shravanmali/Aura-v1/cad/scad_exploded_render.png

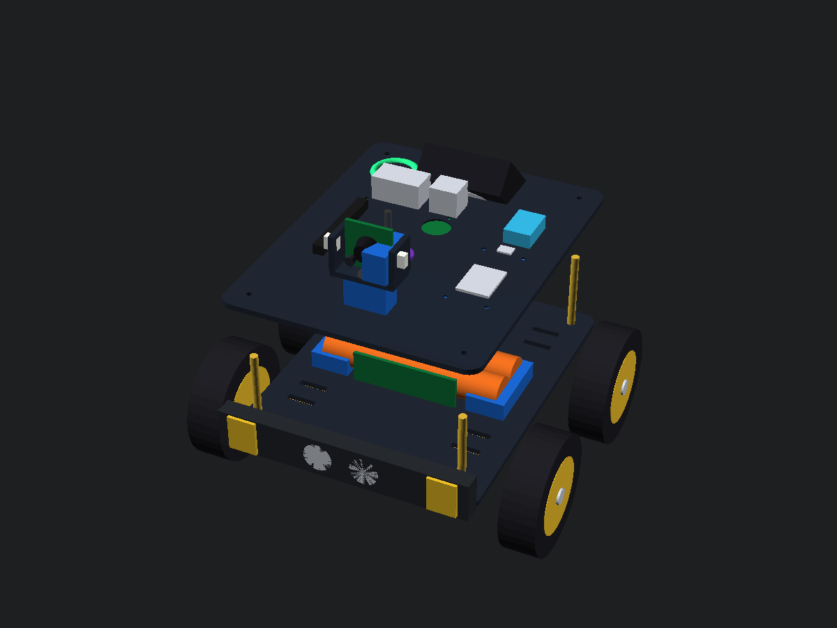
cad/scad_exploded_render.png
