shravanmali/Aura-v1/hardware/Aura_Rover_Carrier_Final/3d_pcb_carrier_top.png

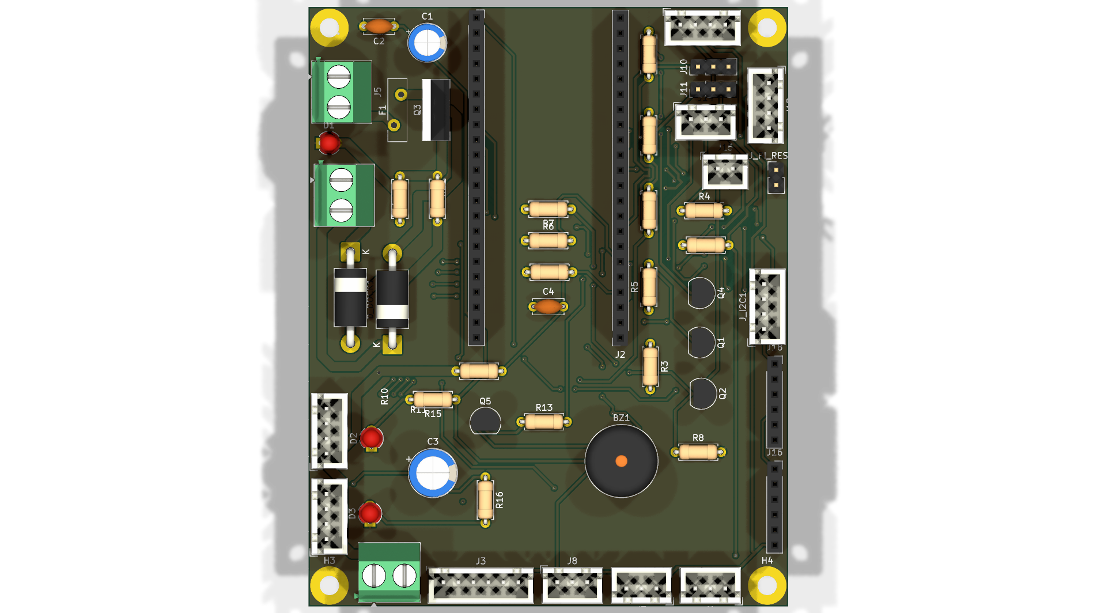
hardware/Aura_Rover_Carrier_Final/3d_pcb_carrier_top.png
