shravanmali/Aura-v1/hardware/Aura_Satellite_Pod/3d_pcb_back.png

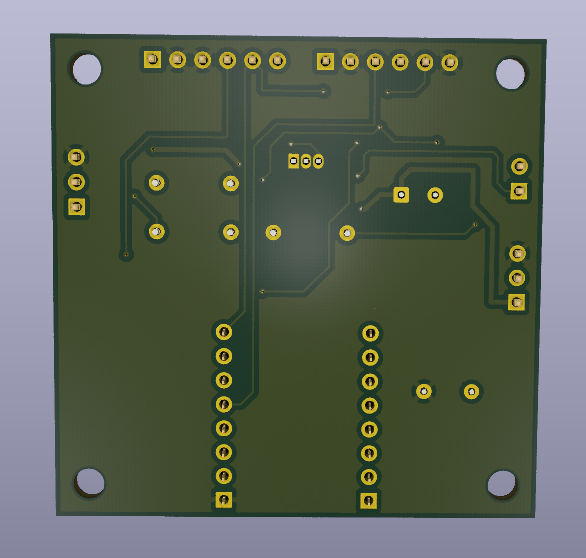
hardware/Aura_Satellite_Pod/3d_pcb_back.png
