shravanmali/Aura-v1/hardware/Aura_Satellite_Pod/3d_pcb_front.png

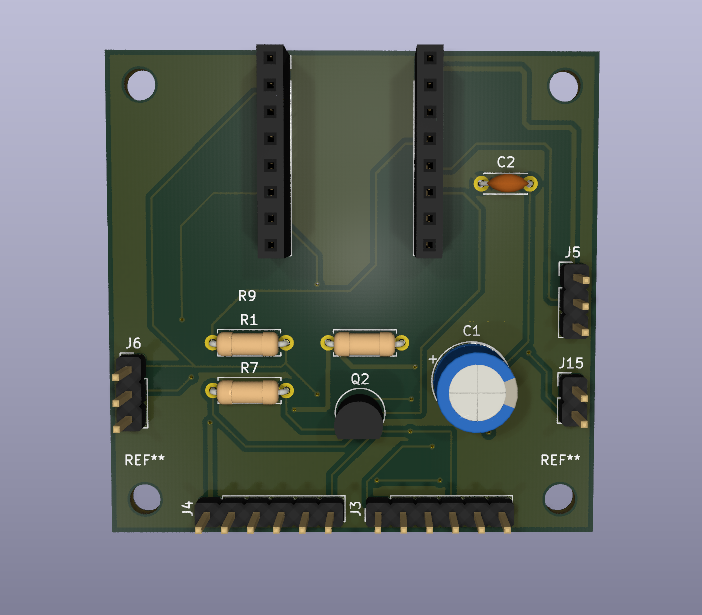
hardware/Aura_Satellite_Pod/3d_pcb_front.png
