shravanmali/Aura-v1/Aura_Master_BOM.md

# Aura v1 — Complete Master System BOM (0 to 100)

> This document lists every single hardware component in the Aura Autonomous Mobile Companion Robot & Bedroom Satellite Mesh.  
> It separates hardware already owned on my desk from hardware requested through the Hack Club Fallen Grant.

---

### Section 1: Hardware Owned by Me (Already on My Desk — ₹0 Grant Needed)

| Item No. | Component Name | Subsystem / Role | Status | Qty | Estimated Value (INR) | Source / Notes |
| :---: | :--- | :--- | :---: | :---: | :---: | :--- |
| D1 | ESP32-S3 DevKit-C (N16R8) | Rover Real-Time Controller & Kinematics | `OWNED / ON DESK` | 1 | ₹850 | On desk (Dual-core 240MHz, 16MB Flash, 8MB PSRAM) |
| D2 | 200RPM Geared BO Motors (3-6V DC) | 4WD Skid-Steer Locomotion | `OWNED / ON DESK` | 4 | ₹240 | On desk (dual parallel pairs for high torque) |
| D3 | High-Grip 65mm Rubber BO Wheels | Rover Ground Traction | `OWNED / ON DESK` | 4 | ₹200 | On desk (rubber tread wheels) |
| D4 | L298N Dual H-Bridge Motor Driver | 4WD Motor Power Driver (up to 2A/channel) | `OWNED / ON DESK` | 1 | ₹160 | On desk (heatsink module driven via ESP32 PWM) |
| D5 | 2-Axis Pan-Tilt Gimbal Bracket Kit | Camera Pan-Tilt Mount (SG90/MG90S footprint) | `OWNED / ON DESK` | 1 | ₹120 | On desk (mechanics for camera tracking) |
| D6 | Laser-Cut Acrylic Dual-Deck Chassis | Rover Structural Body & Standoffs | `OWNED / ON DESK` | 1 | ₹350 | On desk (base deck for motors, top deck for electronics) |
| D7 | DHT11 Temperature & Humidity Sensor | Ambient Room Climate Telemetry | `OWNED / ON DESK` | 1 | ₹70 | On desk (bench tested in Journal #4) |
| D8 | HC-SR501 PIR Motion Sensor | Low-Power Night Sentry Intrusion Alarm | `OWNED / ON DESK` | 1 | ₹65 | On desk (bench tested in Journal #4) |
| D9 | 2N2222 NPN Bipolar Transistors (TO-92) | High-pulse IR LED Driver & Switching | `OWNED / ON DESK` | 3 | ₹15 | Desk parts stock (used in satellite pod circuit) |
| D10 | 940nm High-Power Infrared (IR) LEDs | TV & Air Conditioner Voice Remote Blaster | `OWNED / ON DESK` | 2 | ₹20 | Desk parts stock (narrow-beam 5mm IR emitter) |
| D11 | 1/4W Metal Film Precision Resistors | Fuel Gauge (100k/33k), Pullups, Base Drive | `OWNED / ON DESK` | 15+ | ₹30 | Desk parts stock (100k, 33k, 4.7k, 1k, 100, 47 ohm) |
| D12 | 470µF 25V Low-ESR Electrolytic Capacitor | Audio Inrush Buffer (Prevents speaker brownout) | `OWNED / ON DESK` | 1 | ₹10 | Desk stock (placed across MAX98357A 5V rail) |
| D13 | Single-Sided Copper Perfboard / Zero PCB | Initial Soldered Hardware Carrier Shield | `OWNED / ON DESK` | 1 | ₹40 | On desk (bench wiring shield) |
| D14 | Smartphone (DroidCam USB/Wi-Fi Stream) | Interim CV Camera Node (1080p @ 30 FPS) | `OWNED / ON DESK` | 1 | ₹0 | Personal phone used while awaiting Pi CSI camera |
| D15 | 5V 2A USB Mobile Charger + USB-C Cable | Bedroom Satellite Pod 24/7 Wall Power | `OWNED / ON DESK` | 1 | ₹150 | Spare phone charger used to power the pod |
| — | **Subtotal: Owned Hardware** | **15 Subsystems Already on My Desk** | — | — | **₹2,320** | **Owned by me (I have on my desk)** |

---

### Section 2: Hack Club Fallen Grant Request (₹9,528 / ~$100.67)

| Item No. | Component Name | Purpose on Aura v1 | Status | Qty | Unit Price (INR) | Total Price (INR) | Vendor | Purchase Link |
| :---: | :--- | :--- | :---: | :---: | :---: | :---: | :---: | :---: |
| G1 | Raspberry Pi 4 Model B (1GB) | Main AI Brain & Computer Vision | `REQUESTED` | 1 | ₹4,499 | ₹4,499 | Robocraze | [robocraze.com](https://robocraze.com/products/raspberry-pi-4-model-b-1gb-ram) |
| G2 | 160° Wide-Angle CSI Camera (OV5647) | Person Tracking & Auto-Docking | `REQUESTED` | 1 | ₹939 | ₹939 | Robu.in | [robu.in](https://robu.in/product/5mp-ov5647-sensor-adjustable-wide-angle-fish-eye-lens-night-vision-camera-for-raspberry-pi-3-b/) |
| G3 | TowerPro MG90S Metal Gear Servos | 2-Axis Pan-Tilt Camera Gimbal | `REQUESTED` | 2 | ₹269 | ₹538 | Robu.in | [robu.in](https://robu.in/product/mg90s-9g-servo-metal-gear/) |
| G4 | XL4015 5A DC-DC Buck Converter | 5.1V Clean Power Rail for Pi 4B | `REQUESTED` | 1 | ₹110 | ₹110 | Robocraze | [robocraze.com](https://robocraze.com/products/xl4015-dc-dc-step-down-adjustable-power-supply-module) |
| G5 | LM2596S 3A DC-DC Buck Converter | 5.0V Rail for Servos & LEDs | `REQUESTED` | 1 | ₹62 | ₹62 | Robocraze | [robocraze.com](https://robocraze.com/products/lm2596-dc-dc-buck-module) |
| G6 | 18650 2600mAh Li-ion Cells (3S2P) | 11.1V 5200mAh High-Torque Pack | `REQUESTED` | 6 | ₹149 | ₹894 | MakerBazar | [makerbazar.in](https://makerbazar.in/products/youxi-18650-3-7v-lithium-ion-rechargeable-battery) |
| G7 | 3S 20A Li-ion BMS Protection Board | Battery Safety & Balance Protection | `REQUESTED` | 1 | ₹49 | ₹49 | MakerBazar | [makerbazar.in](https://makerbazar.in/products/12-6v-bms-3s-20a-18650-lithium-battery-management-board) |
| G8 | 12V 2A DC Power Adapter | Auto-Docking Station Power Supply | `REQUESTED` | 1 | ₹129 | ₹129 | MakerBazar | [makerbazar.in](https://makerbazar.in/products/hi-light-led-power-dc-supply-adapter?variant=50055364641008) |
| G9 | ESP32-C3 SuperMini Board | Stationary Bedroom Satellite Pod | `REQUESTED` | 1 | ₹254 | ₹254 | Robocraze | [robocraze.com](https://robocraze.com/products/esp32-c3-super-mini-development-board-unsoldered) |
| G10 | INMP441 I2S MEMS Microphone | Digital Voice AI Input for Pi | `REQUESTED` | 1 | ₹115 | ₹115 | Robocraze | [robocraze.com](https://robocraze.com/products/inmp441-mems-high-precision-omnidirectional-microphone-module-i2s) |
| G11 | SmartElex MAX98357A I2S Amplifier | 3.2W Class-D Digital Audio Amp | `REQUESTED` | 1 | ₹195 | ₹195 | Robocraze | [robocraze.com](https://robocraze.com/products/smartelex-max98357a-i2s-audio-breakout-amplifier-for-raspberry-pi-and-microcontrollers) |
| G12 | 3-inch 4Ω 10W Speaker | Room Voice & Music Playback | `REQUESTED` | 1 | ₹84 | ₹84 | MakerBazar | [makerbazar.in](https://makerbazar.in/products/senior-sound-subwoofer-multimedia-speaker?variant=48251030667504) |
| G13 | WS2812 16-Bit RGB LED Ring | Visual State Feedback Lightbar | `REQUESTED` | 1 | ₹78 | ₹78 | Robocraze | [robocraze.com](https://robocraze.com/products/ws2812-16-bit-rgb-led-round) |
| G14 | SanDisk Ultra 64GB MicroSD Card | Raspberry Pi OS & Model Storage | `REQUESTED` | 1 | ₹1,299 | ₹1,299 | Amazon.in | [amazon.in](https://www.amazon.in/SANDISK-microSD-Android-Smartphones-Warranty/dp/B0GWW13HC3/) |
| G15 | HC-SR04 Ultrasonic Distance Sensor | Front Obstacle Collision Shield | `REQUESTED` | 1 | ₹75 | ₹75 | Robocraze | [robocraze.com](https://robocraze.com/products/hc-sr-04-ultrasonic-sensor) |
| G16 | 40-Pin Dupont Jumper Wires Kit | Interconnect Wiring & Prototyping | `REQUESTED` | 1 | ₹110 | ₹110 | MakerBazar | [makerbazar.in](https://makerbazar.in/products/jumper-cable-male-female) |
| G17 | 3x 18650 Battery Holder with Leads | 3S2P Battery Pack Assembly | `REQUESTED` | 2 | ₹49 | ₹98 | Robu.in | [robu.in](https://robu.in/product/plastic-box-battery-cell-holder-for-4-x-aa-battery-with-on-off-switch/) |
| **TOTAL** | **Complete System Grant Request** | **Aura Rover + Bedroom Satellite Mesh** | — | **17 Items** | — | **₹9,528** | **All Vendors Combined** | **~$100.67 USD** |

---

### Master Total System Value (Owned + Grant)
* **Total Hardware Investment (32 Subsystems):** **₹11,848 (~$125.10 USD)**
  * **Owned by me (I have on my desk):** ₹2,320 (19.6%)
  * **Requested from Hack Club Fallen:** ₹9,528 (80.4%)
