shravanmali/Aura-v1/BOM.md

# Aura v1 — Hardware Grant Request Bill of Materials (BOM)

> **Submission for Hack Club Fallen Grant Review**  
> Total Items: **17 Components** | Total Funding Requested: **₹9,528 (~$100.67 USD)**

| Item No. | Component Name | Purpose on Aura v1 | Quantity | Unit Price (INR) | Total Price (INR) | Total Price (USD) | Vendor | Purchase Link |
| :---: | :--- | :--- | :---: | :---: | :---: | :---: | :---: | :---: |
| 1 | Raspberry Pi 4 Model B (1GB) | Main AI Brain & Computer Vision | 1 | ₹4,499 | ₹4,499 | $47.53 | Robocraze | [robocraze.com](https://robocraze.com/products/raspberry-pi-4-model-b-1gb-ram) |
| 2 | 160° Wide-Angle CSI Camera (OV5647) | Person Tracking & Auto-Docking | 1 | ₹939 | ₹939 | $9.92 | Robu.in | [robu.in](https://robu.in/product/5mp-ov5647-sensor-adjustable-wide-angle-fish-eye-lens-night-vision-camera-for-raspberry-pi-3-b/) |
| 3 | TowerPro MG90S Metal Gear Servos | 2-Axis Pan-Tilt Camera Gimbal | 2 | ₹269 | ₹538 | $5.68 | Robu.in | [robu.in](https://robu.in/product/mg90s-9g-servo-metal-gear/) |
| 4 | XL4015 5A DC-DC Buck Converter | 5.1V Clean Power Rail for Pi 4B | 1 | ₹110 | ₹110 | $1.16 | Robocraze | [robocraze.com](https://robocraze.com/products/xl4015-dc-dc-step-down-adjustable-power-supply-module) |
| 5 | LM2596S 3A DC-DC Buck Converter | 5.0V Rail for Servos & LEDs | 1 | ₹62 | ₹62 | $0.66 | Robocraze | [robocraze.com](https://robocraze.com/products/lm2596-dc-dc-buck-module) |
| 6 | 18650 2600mAh Li-ion Cells (3S2P) | 11.1V 5200mAh High-Torque Pack | 6 | ₹149 | ₹894 | $9.45 | MakerBazar | [makerbazar.in](https://makerbazar.in/products/youxi-18650-3-7v-lithium-ion-rechargeable-battery) |
| 7 | 3S 20A Li-ion BMS Protection Board | Battery Safety & Balance Protection | 1 | ₹49 | ₹49 | $0.52 | MakerBazar | [makerbazar.in](https://makerbazar.in/products/12-6v-bms-3s-20a-18650-lithium-battery-management-board) |
| 8 | 12V 2A DC Power Adapter | Auto-Docking Station Power Supply | 1 | ₹129 | ₹129 | $1.36 | MakerBazar | [makerbazar.in](https://makerbazar.in/products/hi-light-led-power-dc-supply-adapter?variant=50055364641008) |
| 9 | ESP32-C3 SuperMini Board | Stationary Bedroom Satellite Pod | 1 | ₹254 | ₹254 | $2.68 | Robocraze | [robocraze.com](https://robocraze.com/products/esp32-c3-super-mini-development-board-unsoldered) |
| 10 | INMP441 I2S MEMS Microphone | Digital Voice AI Input for Pi | 1 | ₹115 | ₹115 | $1.22 | Robocraze | [robocraze.com](https://robocraze.com/products/inmp441-mems-high-precision-omnidirectional-microphone-module-i2s) |
| 11 | SmartElex MAX98357A I2S Amplifier | 3.2W Class-D Digital Audio Amp | 1 | ₹195 | ₹195 | $2.06 | Robocraze | [robocraze.com](https://robocraze.com/products/smartelex-max98357a-i2s-audio-breakout-amplifier-for-raspberry-pi-and-microcontrollers) |
| 12 | 3-inch 4Ω 10W Speaker | Room Voice & Music Playback | 1 | ₹84 | ₹84 | $0.89 | MakerBazar | [makerbazar.in](https://makerbazar.in/products/senior-sound-subwoofer-multimedia-speaker?variant=48251030667504) |
| 13 | WS2812 16-Bit RGB LED Ring | Visual State Feedback Lightbar | 1 | ₹78 | ₹78 | $0.82 | Robocraze | [robocraze.com](https://robocraze.com/products/ws2812-16-bit-rgb-led-round) |
| 14 | SanDisk Ultra 64GB MicroSD Card | Raspberry Pi OS & Model Storage | 1 | ₹1,299 | ₹1,299 | $13.72 | Amazon.in | [amazon.in](https://www.amazon.in/SANDISK-microSD-Android-Smartphones-Warranty/dp/B0GWW13HC3/) |
| 15 | HC-SR04 Ultrasonic Distance Sensor | Front Obstacle Collision Shield | 1 | ₹75 | ₹75 | $0.79 | Robocraze | [robocraze.com](https://robocraze.com/products/hc-sr-04-ultrasonic-sensor) |
| 16 | 40-Pin Dupont Jumper Wires Kit | Interconnect Wiring & Prototyping | 1 | ₹110 | ₹110 | $1.16 | MakerBazar | [makerbazar.in](https://makerbazar.in/products/jumper-cable-male-female) |
| 17 | 3x 18650 Battery Holder with Leads | 3S2P Battery Pack Assembly | 2 | ₹49 | ₹98 | $1.04 | Robu.in | [robu.in](https://robu.in/product/plastic-box-battery-cell-holder-for-4-x-aa-battery-with-on-off-switch/) |
| **TOTAL** | **Complete System BOM (Rover + Pod)** | **Full Hardware Grant Request** | **17 Items** | — | **₹9,528** | **$100.67** | **All Vendors Combined** | — |
