shravanmali/Aura-v1/hardware/Aura_Rover_Carrier_Final/Aura_Rover_Carrier_Final_BOM.csv

Item | Reference | Value | Footprint
1 | BZ1 | 5V_ACTIVE_BUZZER | Buzzer_Beeper:Buzzer_12x9.5RM7.6
2 | C1 | 100uF 16V | Capacitor_THT:CP_Radial_D6.3mm_P2.50mm
3 | C2 | 100nF | Capacitor_THT:C_Disc_D5.0mm_W2.5mm_P5.00mm
4 | C3 | 470uF 25V Low-ESR | Capacitor_THT:CP_Radial_D8.0mm_P3.50mm
5 | C4 | 100nF | Capacitor_THT:C_Disc_D5.0mm_W2.5mm_P5.00mm
6 | D1 | Green (11.1V OK) | LED_THT:LED_D3.0mm
7 | D2 | Blue (Logic 5V OK) | LED_THT:LED_D3.0mm
8 | D3 | Amber (Servo 5V OK) | LED_THT:LED_D3.0mm
9 | D_DOCK1 | SS54 | Diode_THT:D_DO-201AD_P15.24mm_Horizontal
9b | D_CHG1 | SS54 | Diode_THT:D_DO-201AD_P15.24mm_Horizontal
10 | F1 | 5A 16V Polyfuse | Fuse:Fuse_Bourns_MF-RHT500
11 | H1 | M3_Mounting_Hole | MountingHole:MountingHole_3.2mm_M3_Pad
12 | H2 | M3_Mounting_Hole | MountingHole:MountingHole_3.2mm_M3_Pad
13 | H3 | M3_Mounting_Hole | MountingHole:MountingHole_3.2mm_M3_Pad
14 | H4 | M3_Mounting_Hole | MountingHole:MountingHole_3.2mm_M3_Pad
15 | J1 | ESP32_LEFT | Connector_PinSocket_2.54mm:PinSocket_1x22_P2.54mm_Vertical
16 | J2 | ESP32_RIGHT | Connector_PinSocket_2.54mm:PinSocket_1x22_P2.54mm_Vertical
17 | J3 | L298N_MOTOR_PORT | Connector_JST:JST_XH_B6B-XH-A_1x06_P2.50mm_Vertical
18 | J4 | 5V_BUCK_REGULATOR | Connector_JST:JST_XH_B4B-XH-A_1x04_P2.50mm_Vertical
19 | J5 | 11.1V_BATT_IN | TerminalBlock_Phoenix:TerminalBlock_Phoenix_MKDS-1,5-2-5.08_1x02_P5.08mm_Horizontal
20 | J6 | HC-SR04_ULTRASONIC | Connector_JST:JST_XH_B4B-XH-A_1x04_P2.50mm_Vertical
21 | J7 | DHT11_Sensor | Connector_JST:JST_XH_B3B-XH-A_1x03_P2.50mm_Vertical
22 | J8 | PIR_Motion | Connector_JST:JST_XH_B3B-XH-A_1x03_P2.50mm_Vertical
23 | J9 | WS2812B_8LED_STRIP | Connector_JST:JST_XH_B3B-XH-A_1x03_P2.50mm_Vertical
24 | J10 | SERVO_PAN_MG90S | Connector_PinHeader_2.54mm:PinHeader_1x03_P2.54mm_Vertical
25 | J11 | SERVO_TILT_MG90S | Connector_PinHeader_2.54mm:PinHeader_1x03_P2.54mm_Vertical
26 | J12 | RASPBERRY_PI_4_PORT | Connector_JST:JST_XH_B4B-XH-A_1x04_P2.50mm_Vertical
27 | J13 | LM2596_SERVO_BUCK | Connector_JST:JST_XH_B4B-XH-A_1x04_P2.50mm_Vertical
28 | J14 | F_led | Connector_JST:JST_XH_B3B-XH-A_1x03_P2.50mm_Vertical
29 | J15 | IR_Trx | Connector_JST:JST_XH_B2B-XH-A_1x02_P2.50mm_Vertical
30 | J16 | MAX98357A_AMP | Connector_PinSocket_2.54mm:PinSocket_1x06_P2.54mm_Vertical
31 | J17 | SPEAKER_4OHM | TerminalBlock_Phoenix:TerminalBlock_Phoenix_MKDS-1,5-2-5.08_1x02_P5.08mm_Horizontal
32 | J18 | INMP441_MIC | Connector_PinSocket_2.54mm:PinSocket_1x06_P2.54mm_Vertical
33 | J_DOCK1 | AUTO_DOCK_CHARGER | TerminalBlock_Phoenix:TerminalBlock_Phoenix_MKDS-1,5-2-5.08_1x02_P5.08mm_Horizontal
34 | J_I2C1 | I2C_EXPANSION | Connector_JST:JST_XH_B4B-XH-A_1x04_P2.50mm_Vertical
35 | J_MOTOR1 | L298N_MOTOR_PWR | TerminalBlock_Phoenix:TerminalBlock_Phoenix_MKDS-1,5-2-5.08_1x02_P5.08mm_Horizontal
36 | J_PI_RESET1 | PI_RUN_HEADER | Connector_PinHeader_2.54mm:PinHeader_1x02_P2.54mm_Vertical
37 | Q1 | 2N2222 | Package_TO_SOT_THT:TO-92_Inline
38 | Q2 | 2N2222 | Package_TO_SOT_THT:TO-92_Inline
39 | Q3 | Q_PMOS_GSD | Package_TO_SOT_THT:TO-220-3_Vertical
40 | Q4 | 2N2222 | Package_TO_SOT_THT:TO-92_Inline
41 | Q5 | 2N2222 | Package_TO_SOT_THT:TO-92_Inline
42 | R1 | 1k | Resistor_THT:R_Axial_DIN0207_L6.3mm_D2.5mm_P10.16mm_Horizontal
43 | R2 | 2k | Resistor_THT:R_Axial_DIN0207_L6.3mm_D2.5mm_P10.16mm_Horizontal
44 | R3 | 100Ω | Resistor_THT:R_Axial_DIN0207_L6.3mm_D2.5mm_P10.16mm_Horizontal
45 | R4 | 100Ω | Resistor_THT:R_Axial_DIN0207_L6.3mm_D2.5mm_P10.16mm_Horizontal
46 | R5 | 1k | Resistor_THT:R_Axial_DIN0207_L6.3mm_D2.5mm_P10.16mm_Horizontal
47 | R6 | 10k | Resistor_THT:R_Axial_DIN0207_L6.3mm_D2.5mm_P10.16mm_Horizontal
48 | R7 | 1k | Resistor_THT:R_Axial_DIN0207_L6.3mm_D2.5mm_P10.16mm_Horizontal
49 | R8 | 10k | Resistor_THT:R_Axial_DIN0207_L6.3mm_D2.5mm_P10.16mm_Horizontal
50 | R9 | 100Ω | Resistor_THT:R_Axial_DIN0207_L6.3mm_D2.5mm_P10.16mm_Horizontal
51 | R11 | 33kΩ | Resistor_THT:R_Axial_DIN0207_L6.3mm_D2.5mm_P10.16mm_Horizontal
52 | R12 | 100k | Resistor_THT:R_Axial_DIN0207_L6.3mm_D2.5mm_P10.16mm_Horizontal
53 | R13 | 4.7kΩ | Resistor_THT:R_Axial_DIN0207_L6.3mm_D2.5mm_P10.16mm_Horizontal
54 | R14 | 1k | Resistor_THT:R_Axial_DIN0207_L6.3mm_D2.5mm_P10.16mm_Horizontal
55 | R15 | 1k | Resistor_THT:R_Axial_DIN0207_L6.3mm_D2.5mm_P10.16mm_Horizontal
56 | R17 | 1k | Resistor_THT:R_Axial_DIN0207_L6.3mm_D2.5mm_P10.16mm_Horizontal
57 | R18 | 1k | Resistor_THT:R_Axial_DIN0207_L6.3mm_D2.5mm_P10.16mm_Horizontal
