shravanmali/Aura-v1/hardware/Aura_Rover_Carrier_Final/Aura_Rover_Carrier_Final_Schematic.pdf

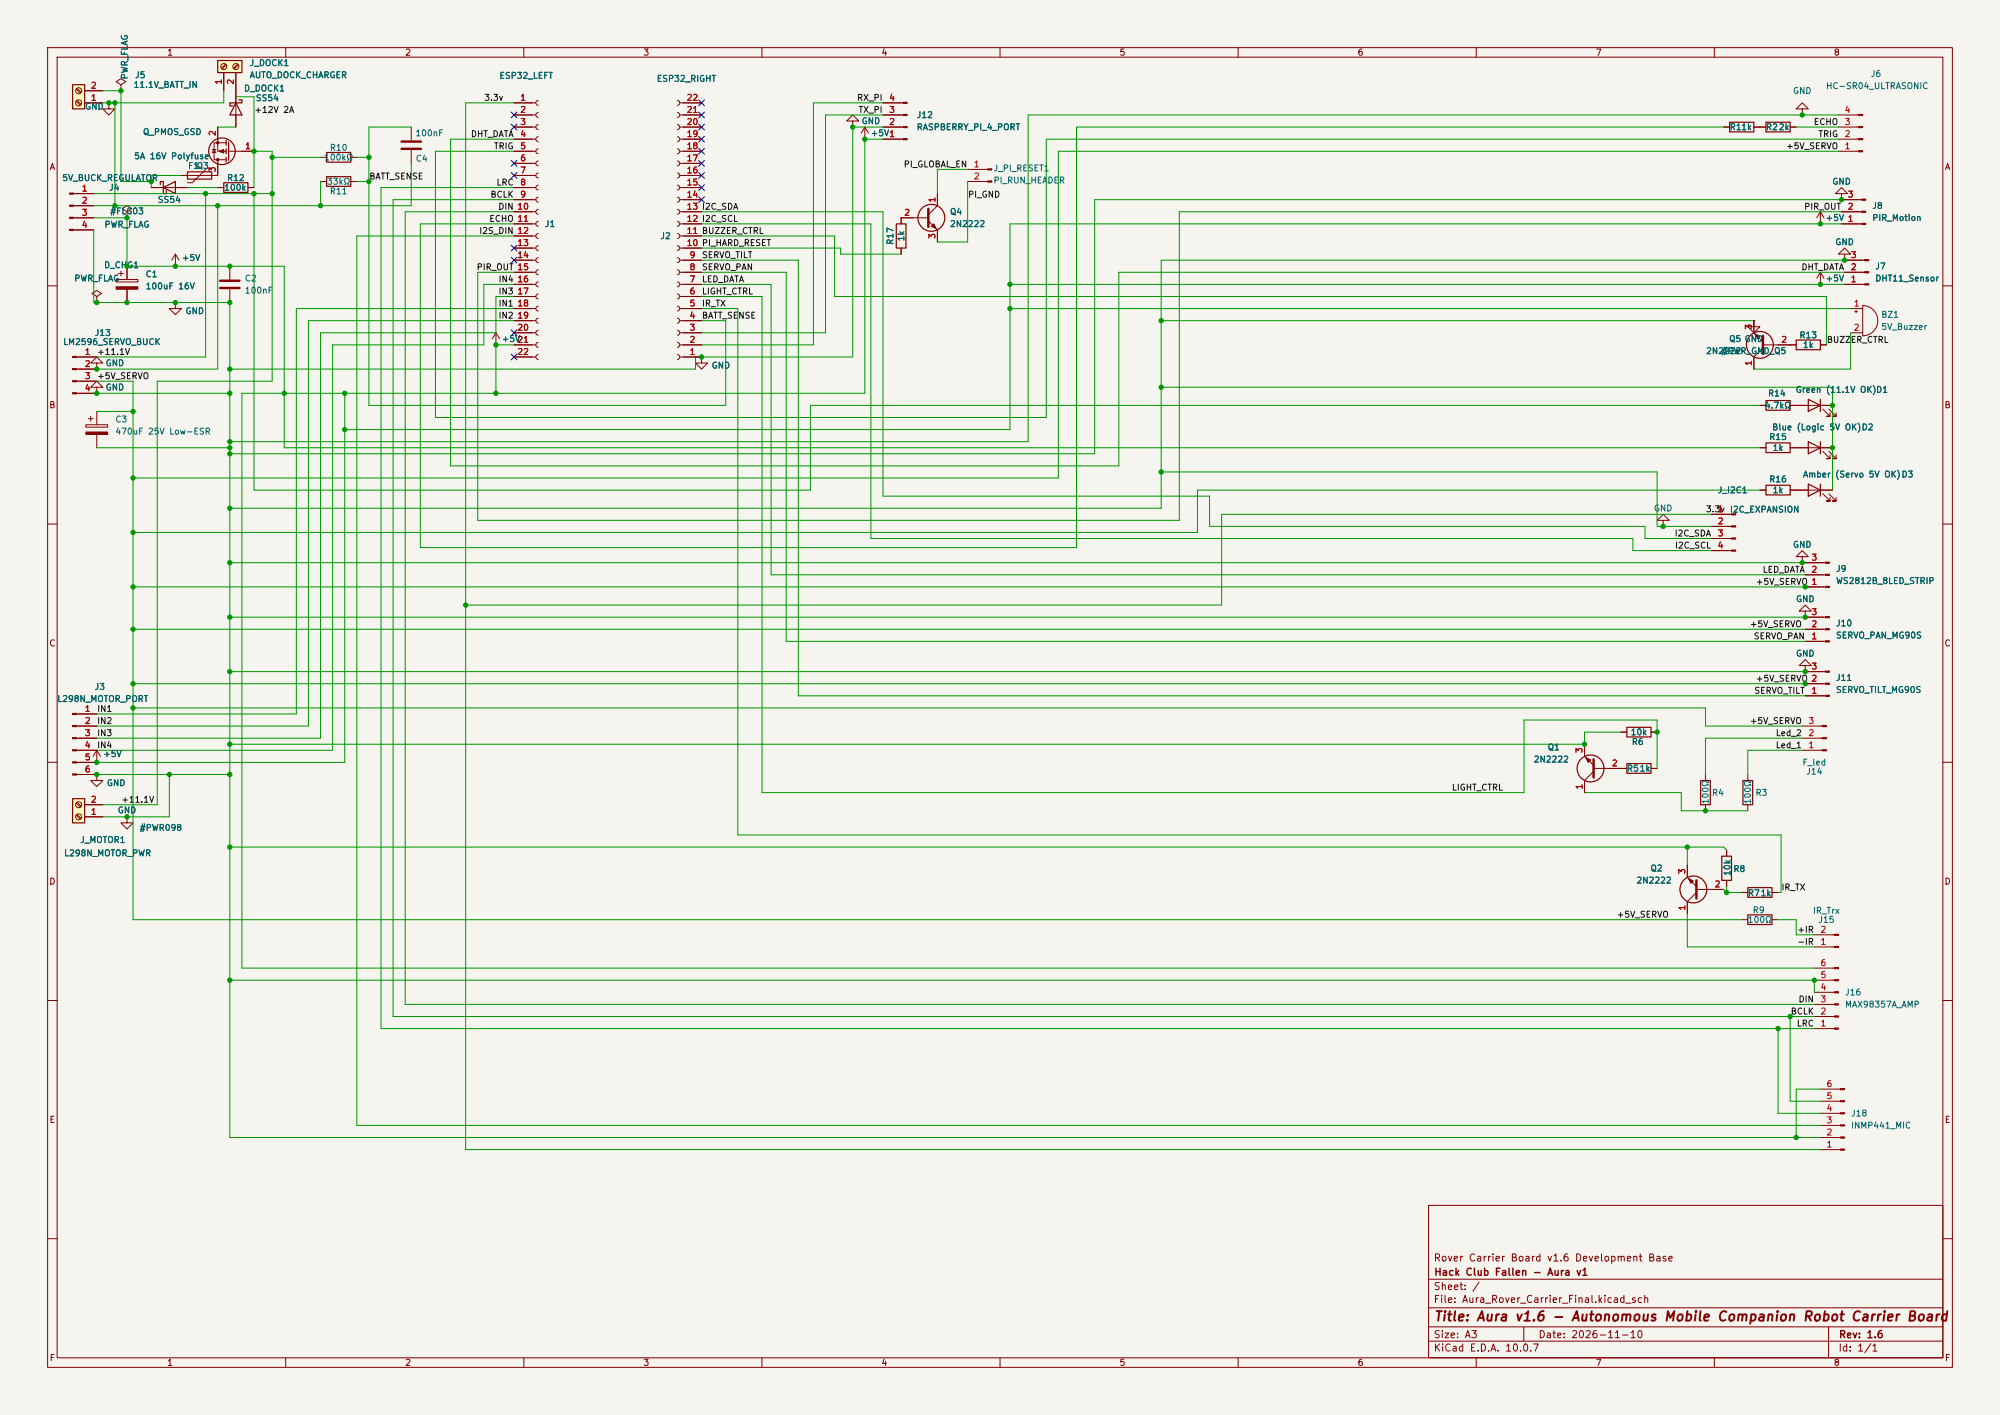
[picture p11: page 1]

Rover Carrier Board v1.6 Development Base
Hack Club Fallen - Aura v1
Sheet: /
File: Aura_Rover_Carrier_Final.kicad_sch
Title: Aura v1.6 - Autonomous Mobile Companion Robot Carrier Board

Size: A3 | Rev: 1.6 | F Date: 2026-11-10
KiCad E.D.A. 10.0.7 | Id: 1/1
