shravanmali/Aura-v1/hardware/Aura_Satellite_Pod/Aura_Satellite_Pod_Schematic.pdf

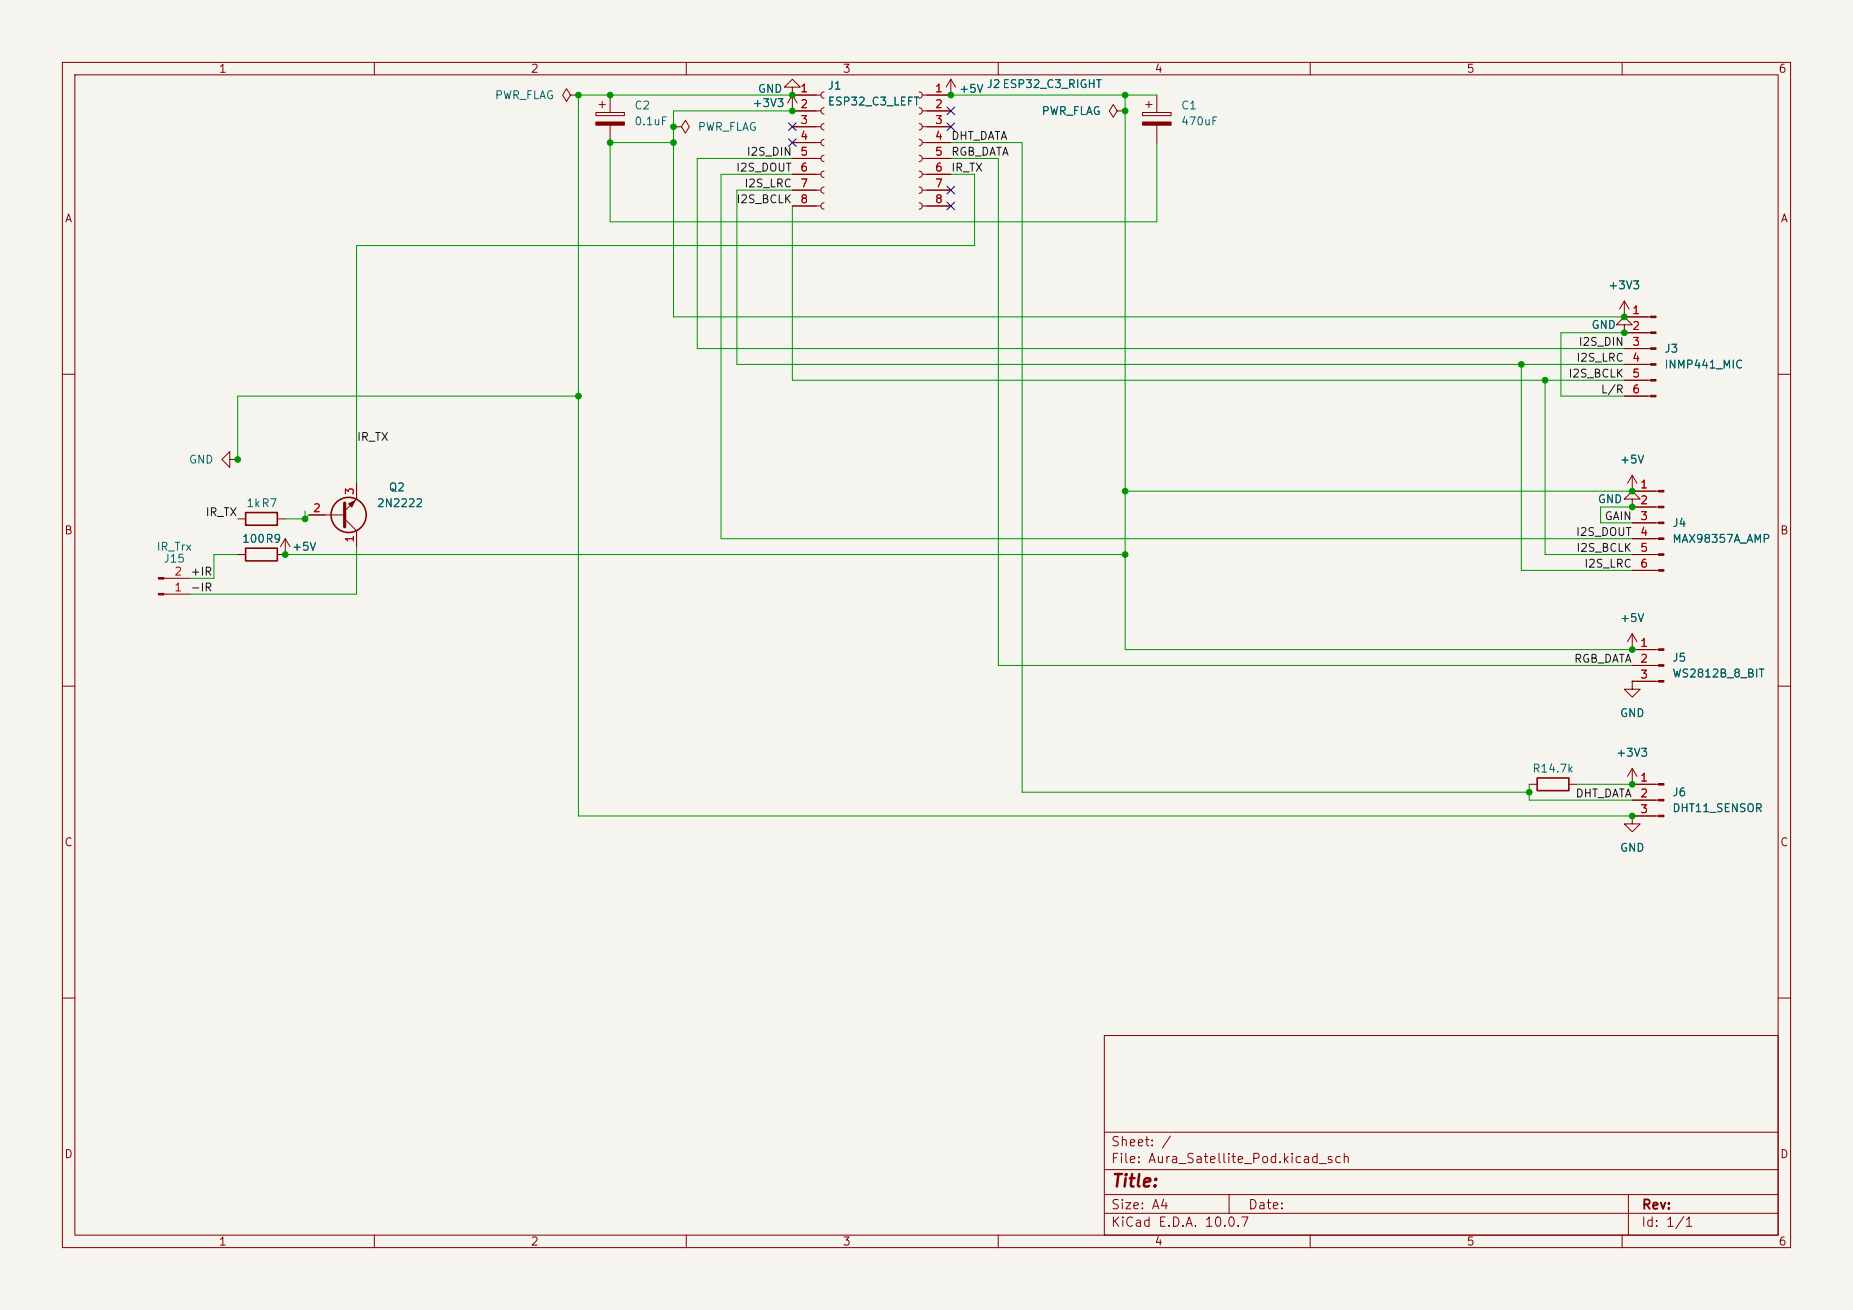
[picture p12: page 1]

Size: A4 | Rev:
KiCad E.D.A. 10.0.7 | Id: 1/1
