shravanmali/Aura-v1/hardware/Aura_v1.5_Carrier/Aura_v1.5_Carrier_Schematic.pdf

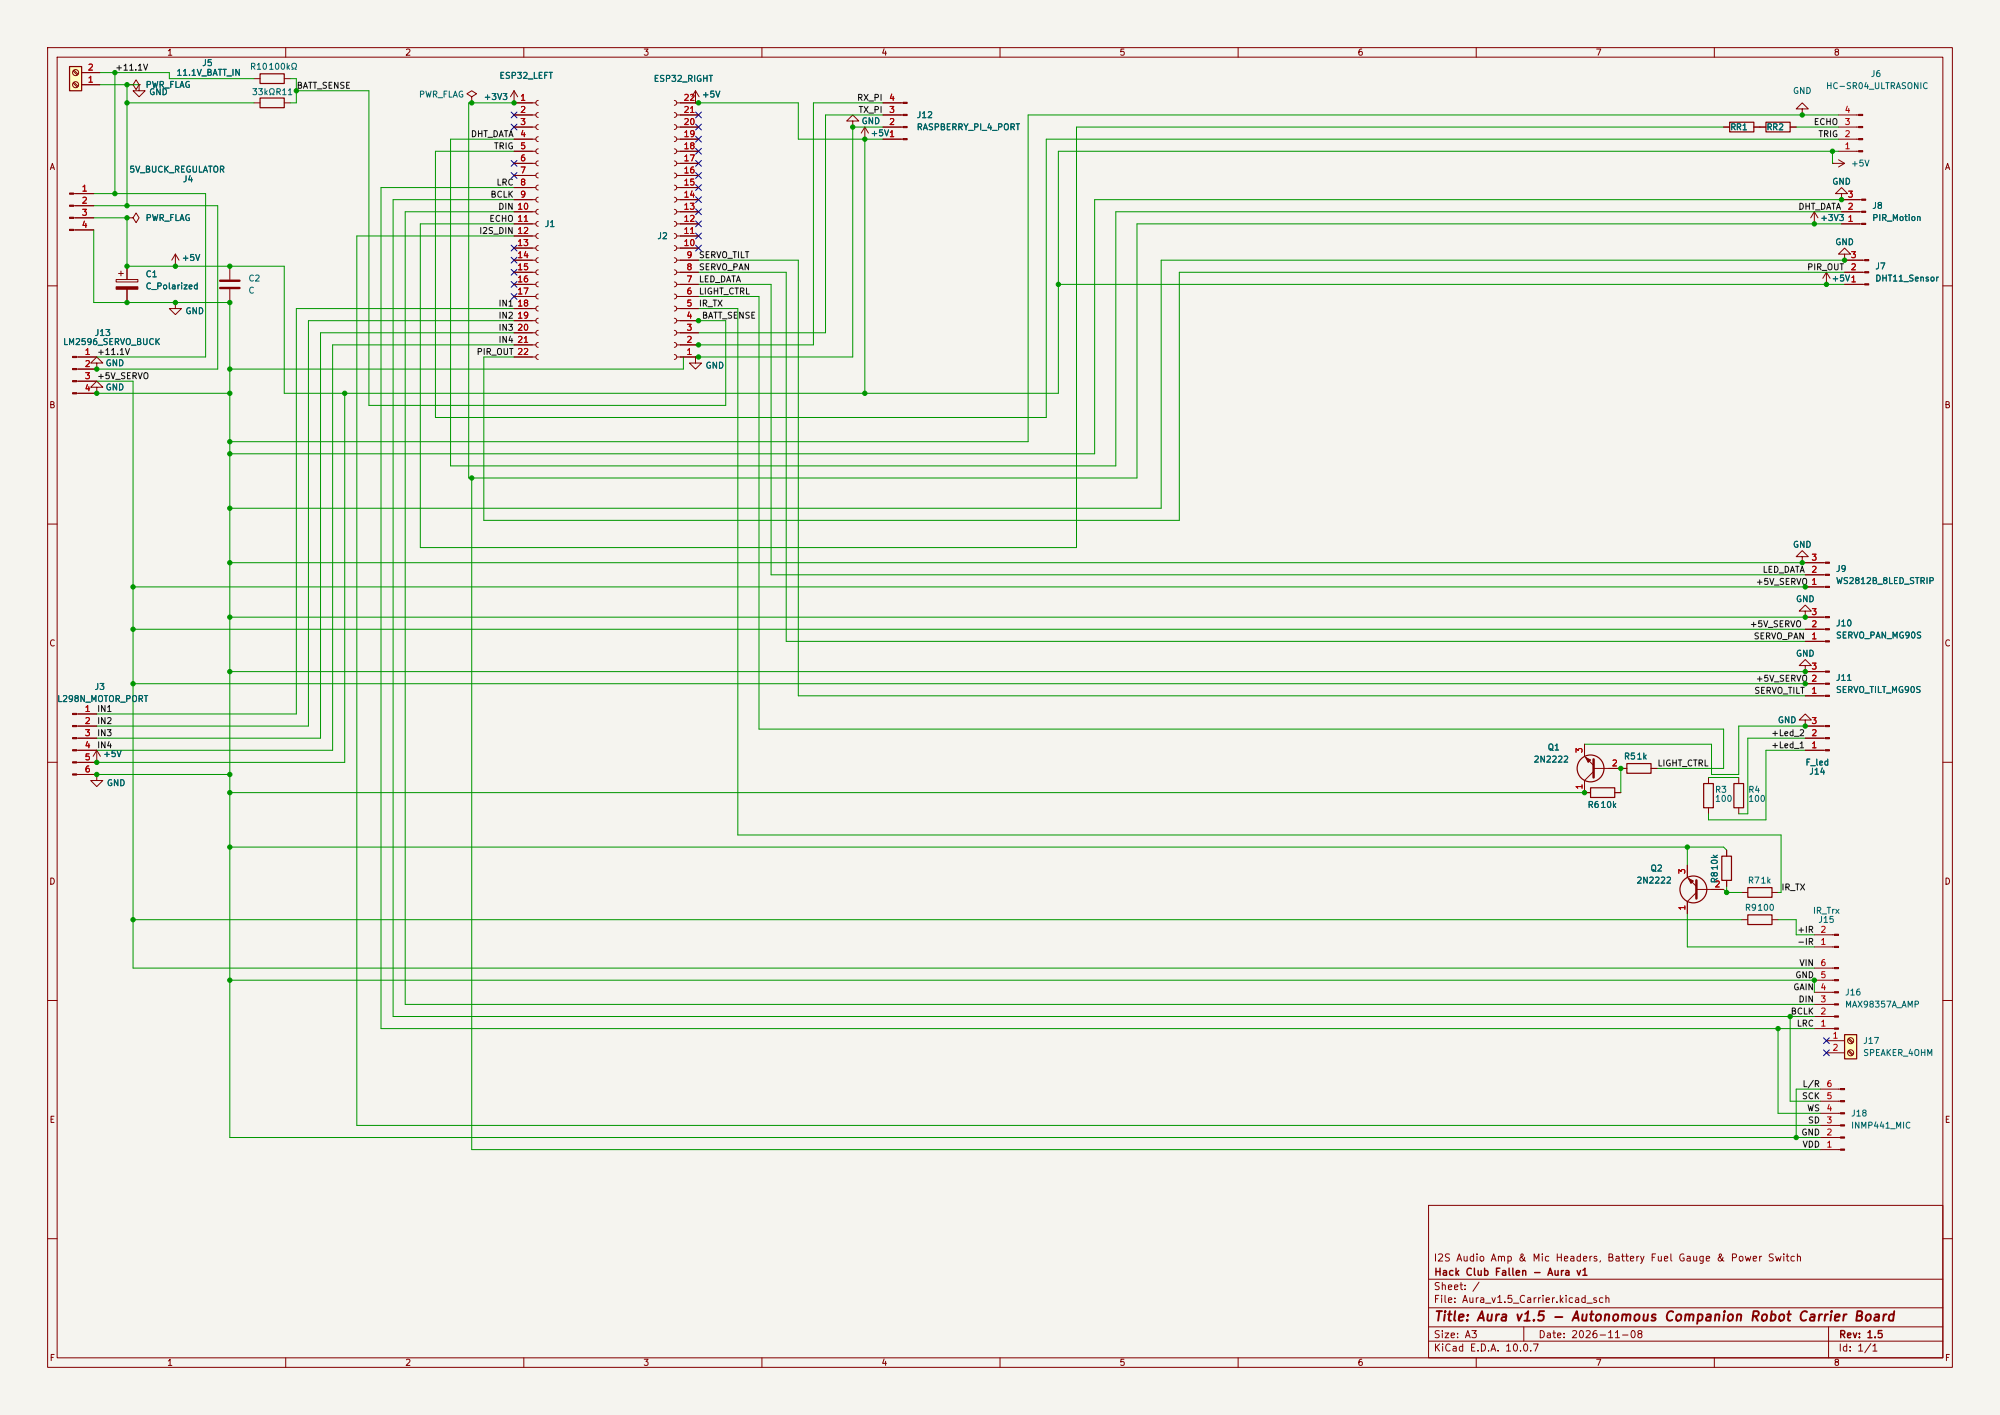
[picture p13: page 1]

I2S Audio Amp & Mic Headers, Battery Fuel Gauge & Power Switch
Hack Club Fallen - Aura v1
Sheet: /
File: Aura_v1.5_Carrier.kicad_sch
Title: Aura v1.5 - Autonomous Companion Robot Carrier Board

Size: A3 | Rev: 1.5 | F Date: 2026-11-08
KiCad E.D.A. 10.0.7 | Id: 1/1
