shravanmali/Aura-v1/hardware/Aura_v1.4_Carrier/Aura_v1.4_Carrier_Schematic.pdf

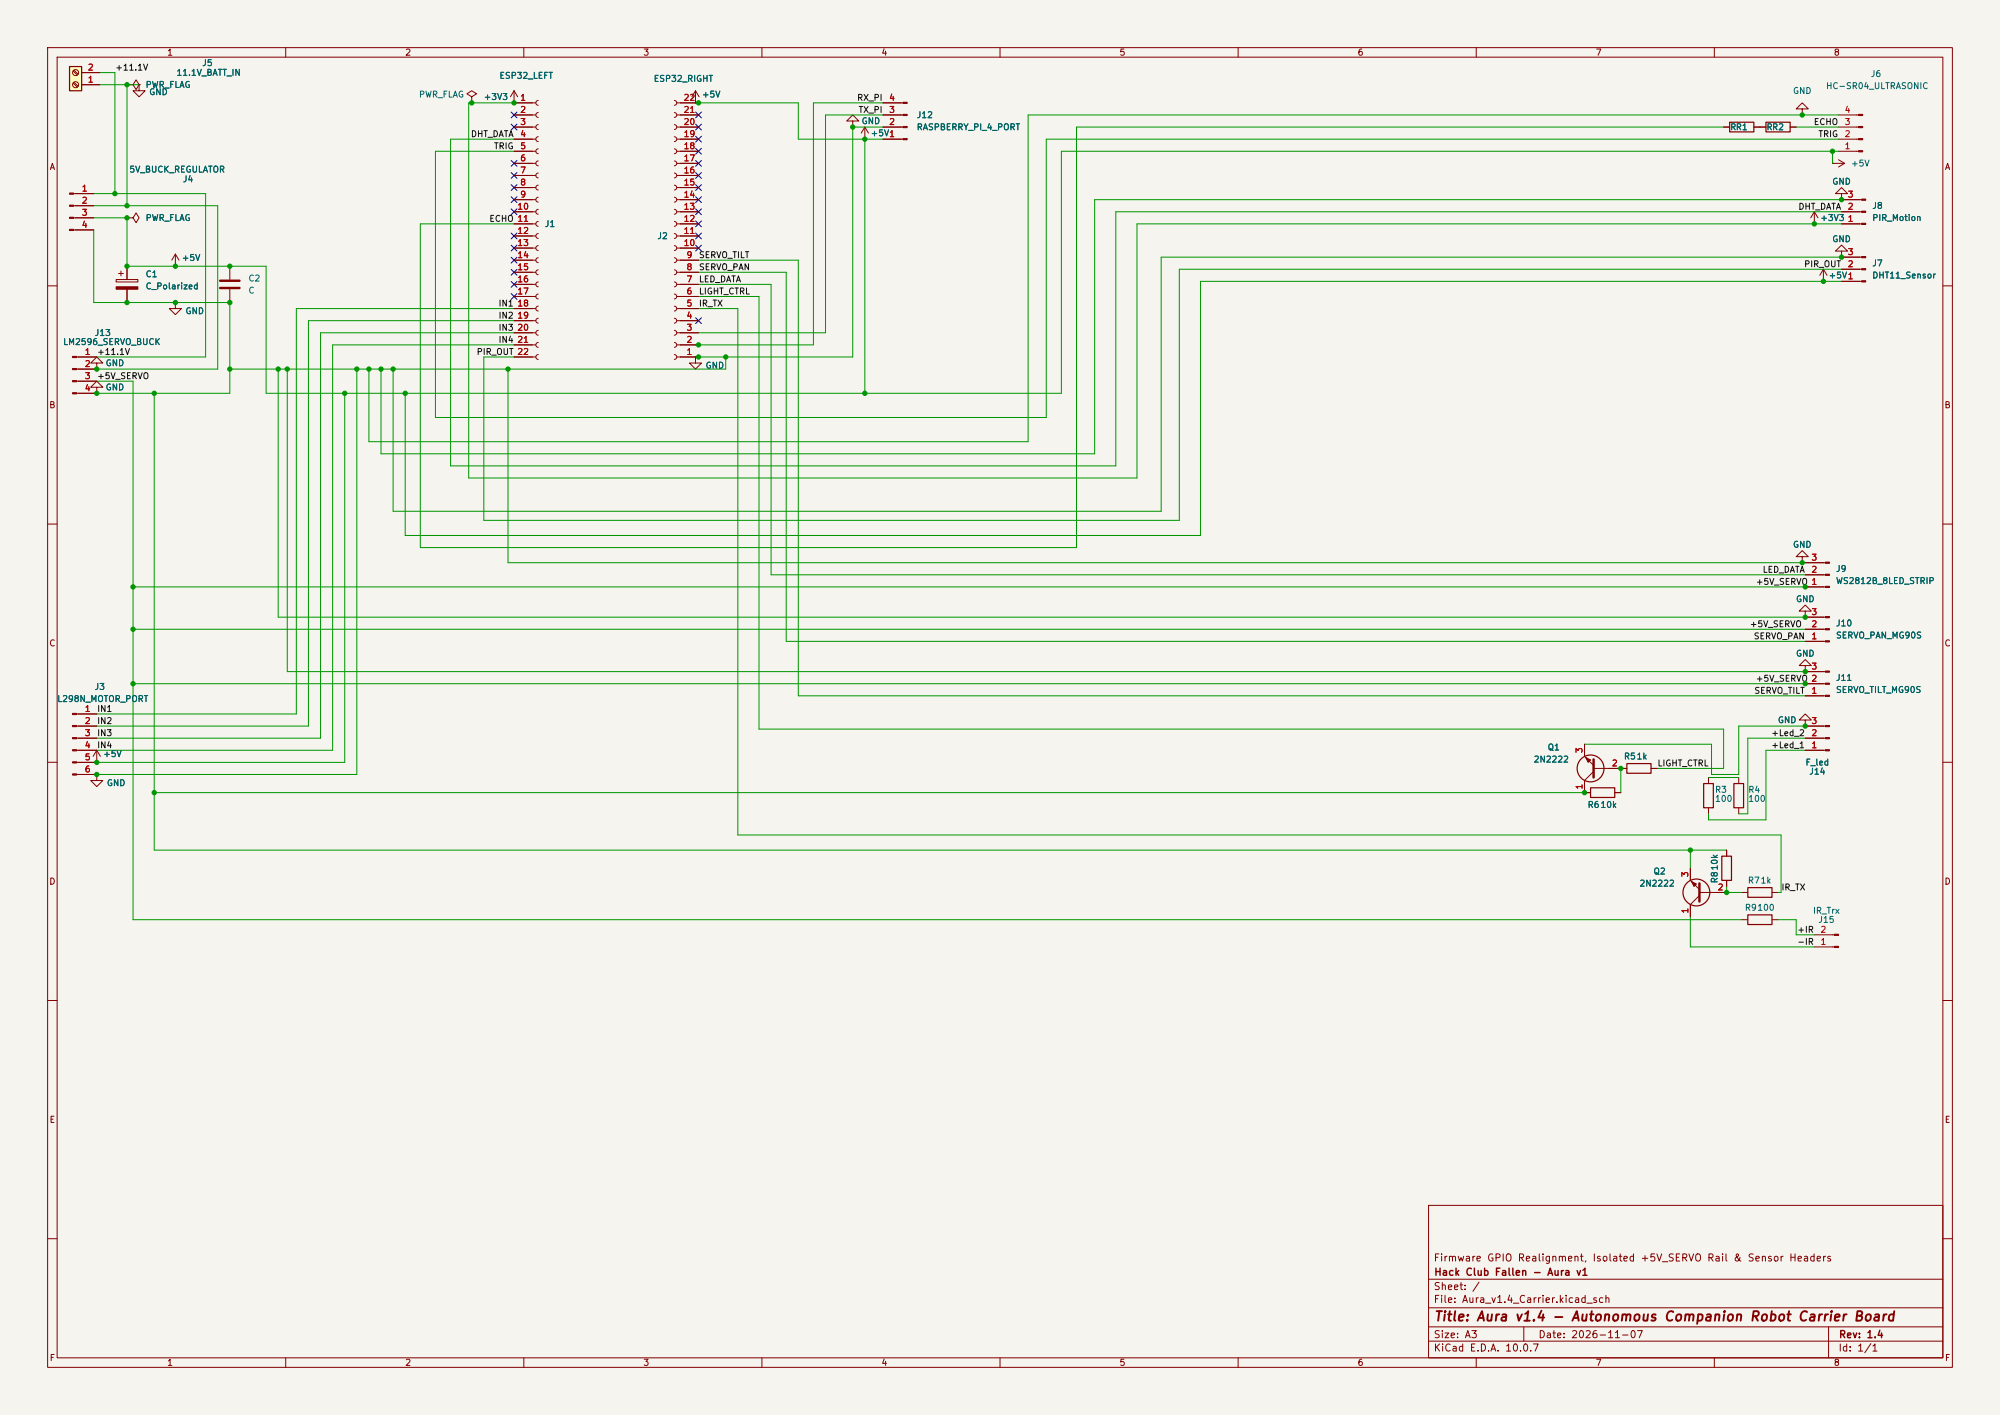
[picture p14: page 1]

Firmware GPIO Realignment, Isolated +5V_SERVO Rail & Sensor Headers
Hack Club Fallen - Aura v1
Sheet: /
File: Aura_v1.4_Carrier.kicad_sch
Title: Aura v1.4 - Autonomous Companion Robot Carrier Board

Size: A3 | Rev: 1.4 | F Date: 2026-11-07
KiCad E.D.A. 10.0.7 | Id: 1/1
