shravanmali/Aura-v1/hardware/Aura_v1.3_Carrier/Aura_v1.3_Carrier_Schematic.pdf

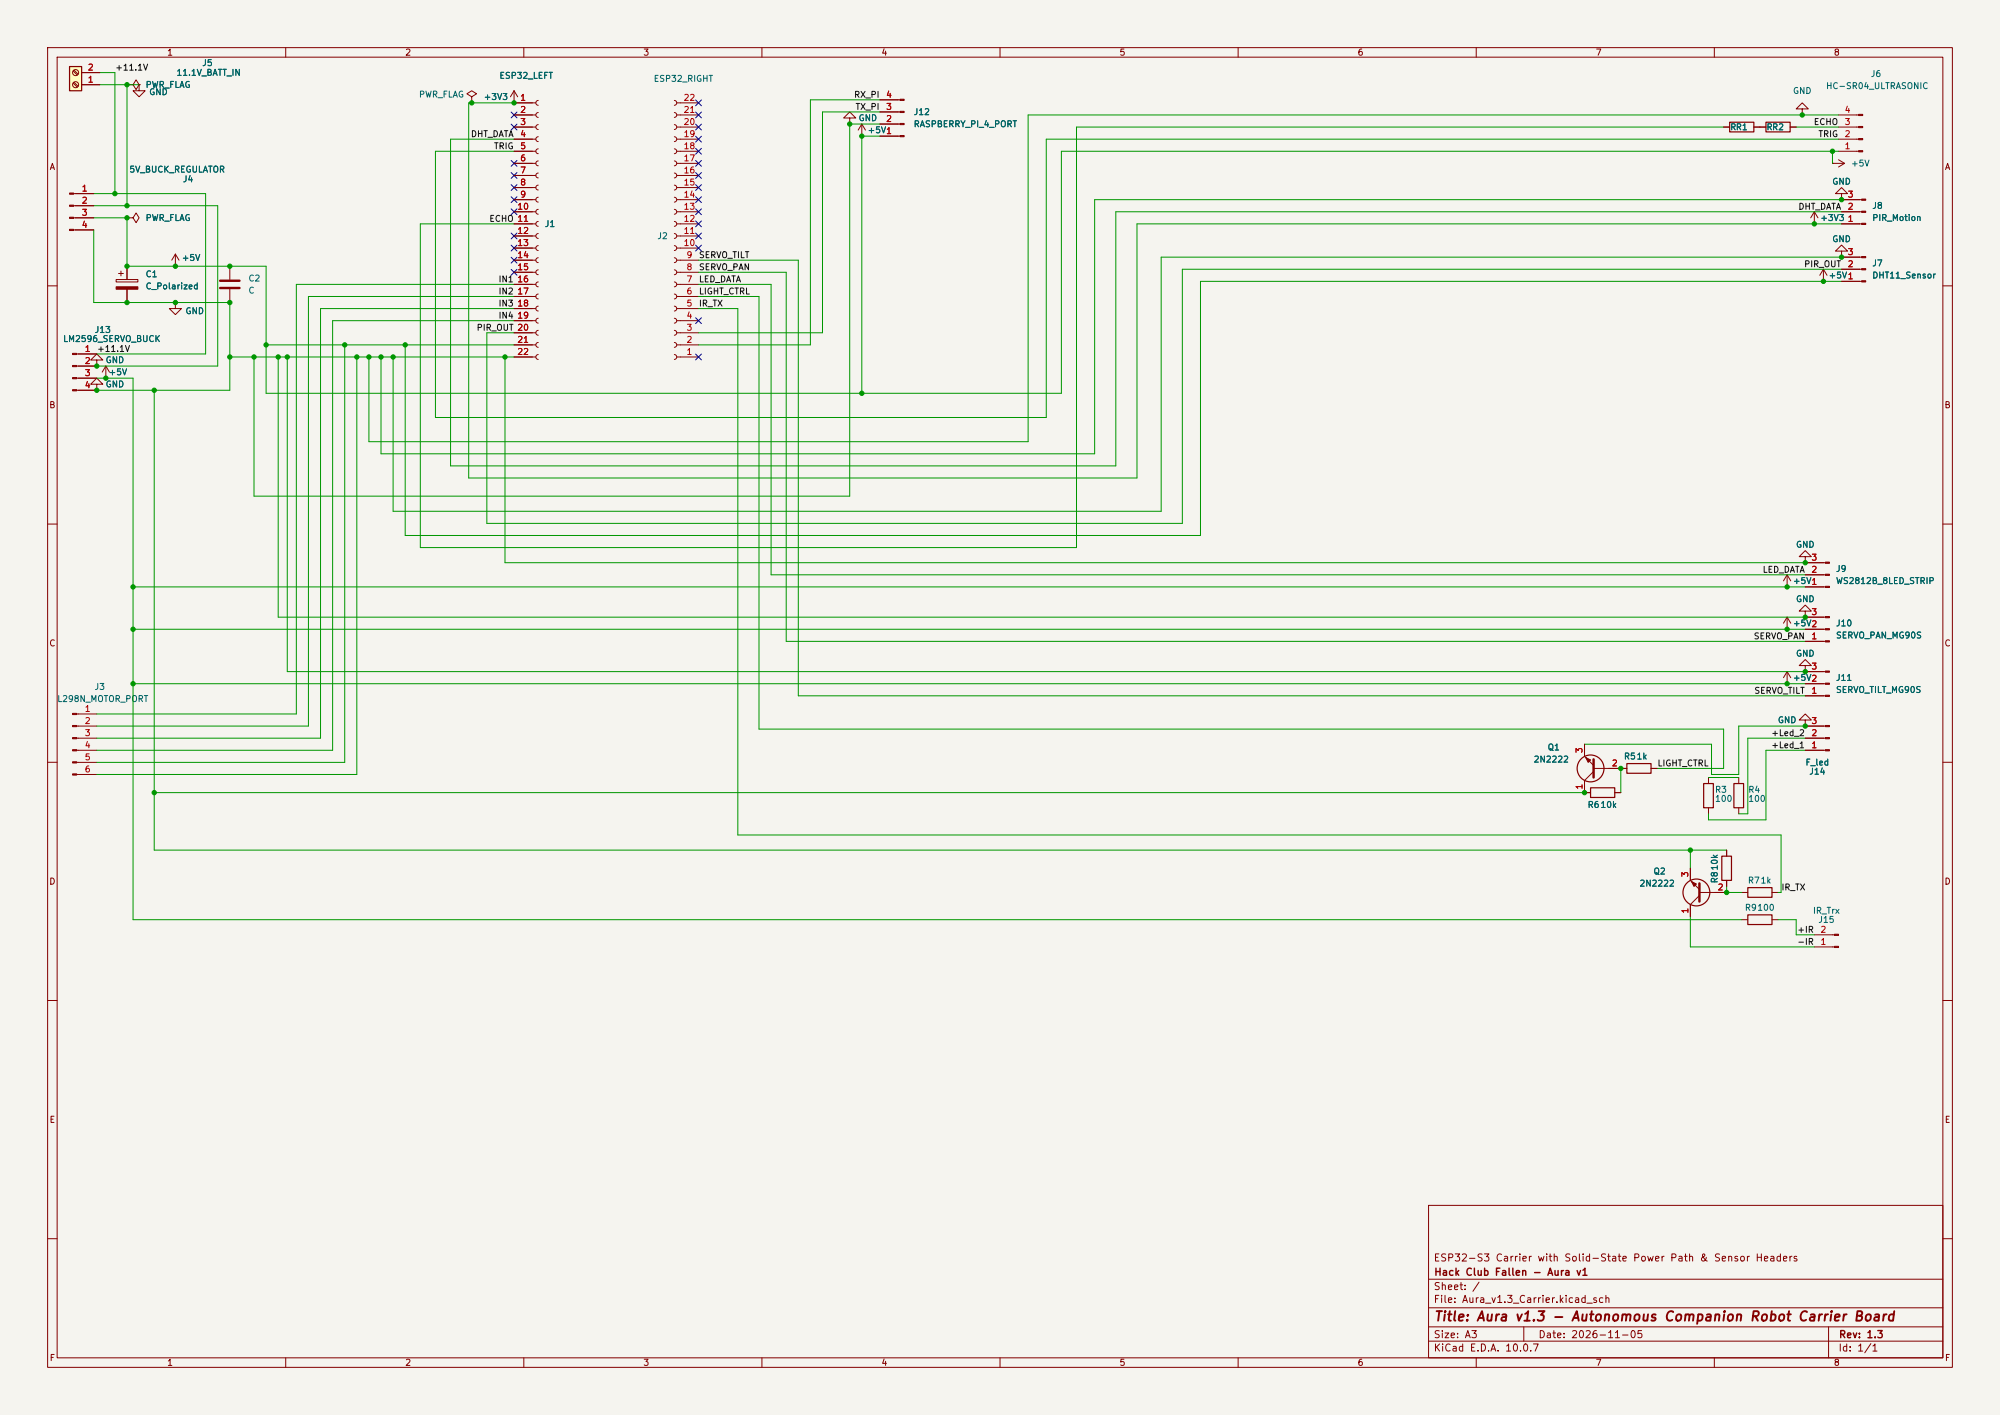
[picture p15: page 1]

ESP32-S3 Carrier with Solid-State Power Path & Sensor Headers
Hack Club Fallen - Aura v1
Sheet: /
File: Aura_v1.3_Carrier.kicad_sch
Title: Aura v1.3 - Autonomous Companion Robot Carrier Board

Size: A3 | Rev: 1.3 | F Date: 2026-11-05
KiCad E.D.A. 10.0.7 | Id: 1/1
