shravanmali/Aura-v1/hardware/Aura_v1.1_Carrier/Aura_v1.1_Carrier_Schematic.pdf

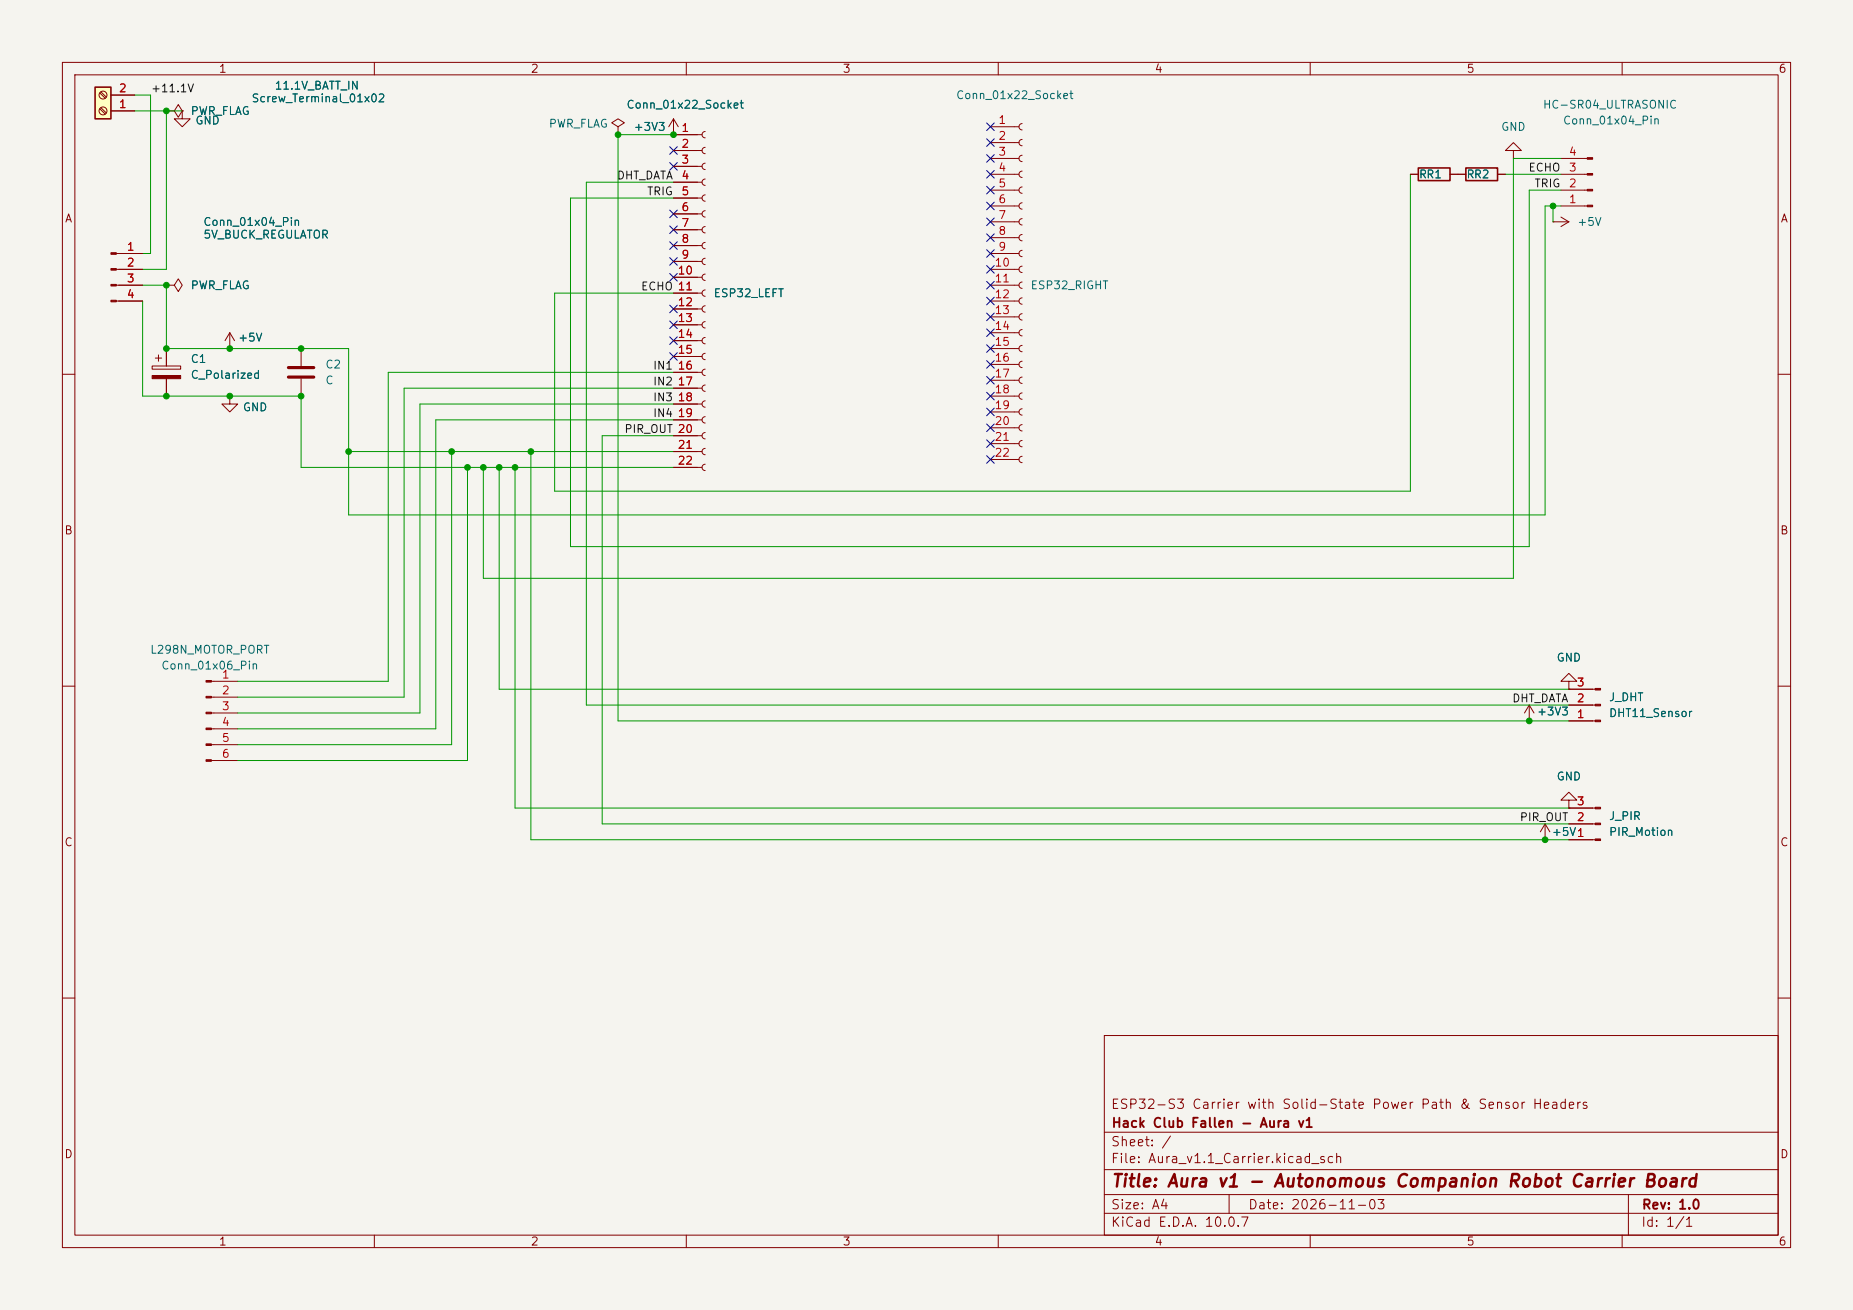
[picture p16: page 1]

ESP32-S3 Carrier with Solid-State Power Path & Sensor Headers
Hack Club Fallen - Aura v1
Sheet: /
File: Aura_v1.1_Carrier.kicad_sch
Title: Aura v1 - Autonomous Companion Robot Carrier Board

Size: A4 | Rev: 1.0
KiCad E.D.A. 10.0.7 | Id: 1/1
