shravanmali/Aura-v1/hardware/Aura_Rover_Carrier_Final/Aura_Rover_Carrier_Final.kicad_pcb

## KiCad design hardware/Aura_Rover_Carrier_Final/Aura_Rover_Carrier_Final.kicad_pcb (2026-11-11)

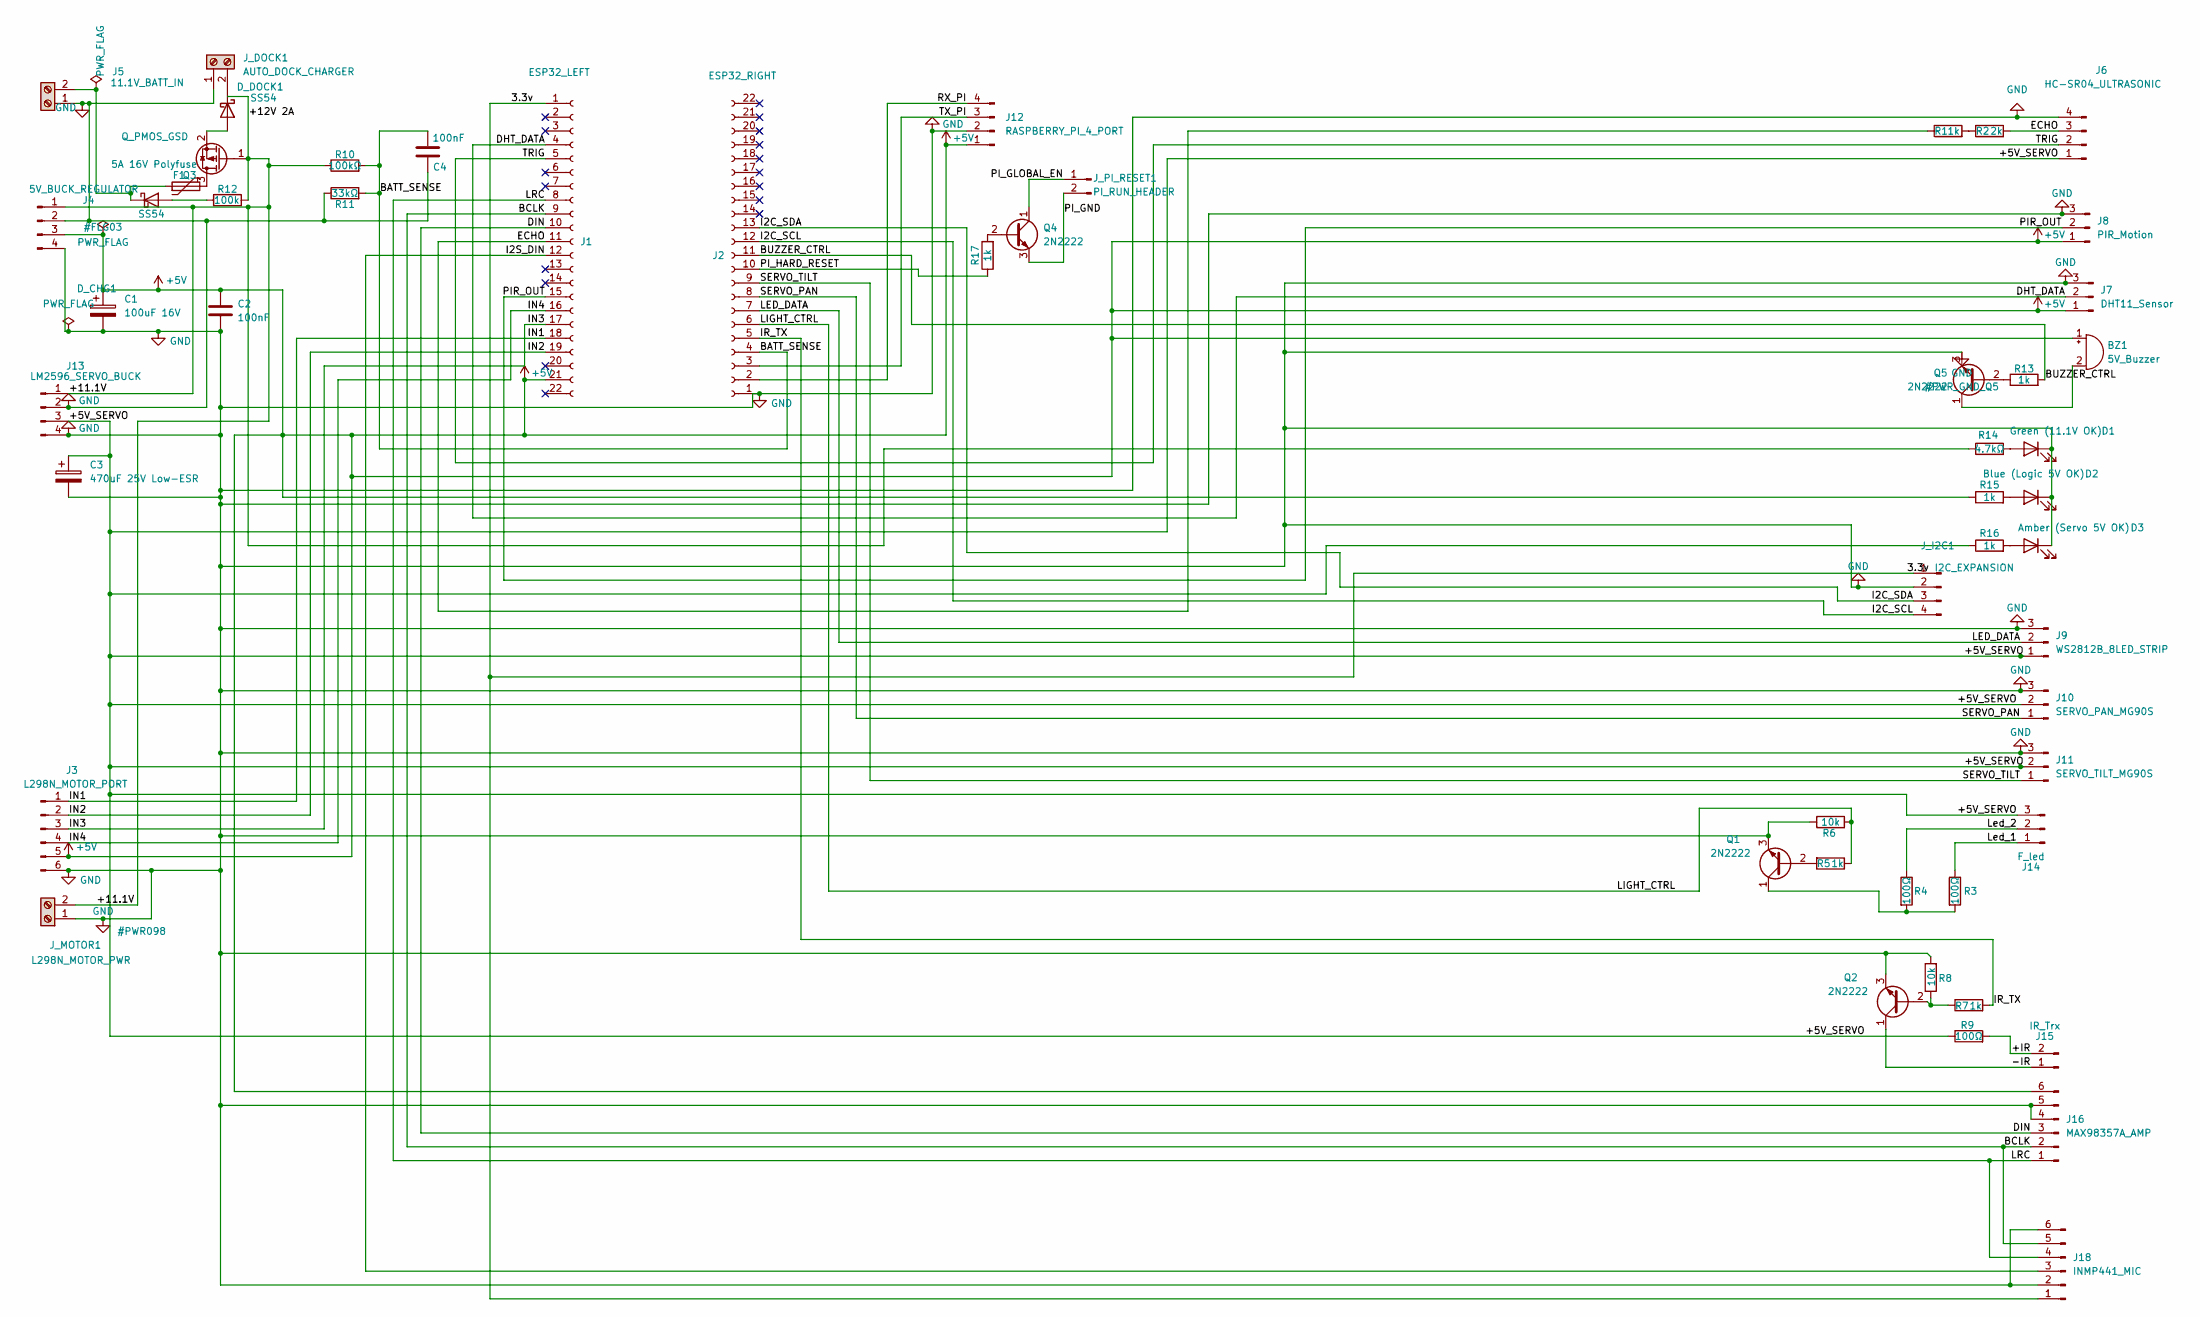
[picture p17: schematic Aura_Rover_Carrier_Final.kicad_sch, Aura v1.6 - Autonomous Mobile Companion Robot Carrier Board]

Parts:
BZ1: 5V_Buzzer; Buzzer_12x9.5RM7.6
C1: 100uF 16V; CP_Radial_D6.3mm_P2.50mm
C2, C4: 100nF; C_Disc_D5.0mm_W2.5mm_P5.00mm
C3: 470uF 25V Low-ESR; CP_Radial_D8.0mm_P3.50mm
D1: Green (11.1V OK); LED_D3.0mm
D2: Blue (Logic 5V OK); LED_D3.0mm
D3: Amber (Servo 5V OK); LED_D3.0mm
D_CHG1: SS54; D_DO-201AD_P15.24mm_Horizontal
D_DOCK1: SS54; D_DO-201AD_P15.24mm_Horizontal
F1: 5A 16V Polyfuse; Fuse_Bourns_MF-RG500
J1: ESP32_LEFT; PinSocket_1x22_P2.54mm_Vertical
J2: ESP32_RIGHT; PinSocket_1x22_P2.54mm_Vertical
J3: L298N_MOTOR_PORT; JST_XH_B6B-XH-A_1x06_P2.50mm_Vertical
J4: 5V_BUCK_REGULATOR; JST_XH_B4B-XH-A_1x04_P2.50mm_Vertical
J5: 11.1V_BATT_IN; TerminalBlock_Phoenix_MKDS-1,5-2-5.08_1x02_P5.08mm_Horizont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
J6: HC-SR04_ULTRASONIC; JST_XH_B4B-XH-A_1x04_P2.50mm_Vertical
J7: DHT11_Sensor; JST_XH_B3B-XH-A_1x03_P2.50mm_Vertical
J8: PIR_Motion; JST_XH_B3B-XH-A_1x03_P2.50mm_Vertical
J9: WS2812B_8LED_STRIP; JST_XH_B3B-XH-A_1x03_P2.50mm_Vertical
J10: SERVO_PAN_MG90S; PinHeader_1x03_P2.54mm_Vertical
J11: SERVO_TILT_MG90S; PinHeader_1x03_P2.54mm_Vertical
J12: RASPBERRY_PI_4_PORT; JST_XH_B4B-XH-A_1x04_P2.50mm_Vertical
J13: LM2596_SERVO_BUCK; JST_XH_B4B-XH-A_1x04_P2.50mm_Vertical
J14: F_led; JST_XH_B3B-XH-A_1x03_P2.50mm_Vertical
J15: IR_Trx; JST_XH_B2B-XH-A_1x02_P2.50mm_Vertical
J16: MAX98357A_AMP; PinSocket_1x06_P2.54mm_Vertical
J18: INMP441_MIC; PinSocket_1x06_P2.54mm_Vertical
J_DOCK1: AUTO_DOCK_CHARGER; TerminalBlock_Phoenix_MKDS-1,5-2-5.08_1x02_P5.08mm_Horizont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
J_I2C1: I2C_EXPANSION; JST_XH_B4B-XH-A_1x04_P2.50mm_Vertical
J_MOTOR1: L298N_MOTOR_PWR; TerminalBlock_Phoenix_MKDS-1,5-2-5.08_1x02_P5.08mm_Horizont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
J_PI_RESET1: PI_RUN_HEADER; PinHeader_1x02_P2.54mm_Vertical
Q1, Q2, Q4, Q5: 2N2222; TO-92_Inline
Q3: Q_PMOS_GSD; TO-220-3_Vertical
R1, R5, R7, R13, R15, R16, R17: 1k; R_Axial_DIN0207_L6.3mm_D2.5mm_P7.62mm_Horizontal
R2: 2k; R_Axial_DIN0207_L6.3mm_D2.5mm_P7.62mm_Horizontal
R3, R4, R9: 100Ω; R_Axial_DIN0207_L6.3mm_D2.5mm_P7.62mm_Horizontal
R6, R8: 10k; R_Axial_DIN0207_L6.3mm_D2.5mm_P7.62mm_Horizontal
R10: 100kΩ; R_Axial_DIN0207_L6.3mm_D2.5mm_P7.62mm_Horizontal
R11: 33kΩ; R_Axial_DIN0207_L6.3mm_D2.5mm_P7.62mm_Horizontal
R12: 100k; R_Axial_DIN0207_L6.3mm_D2.5mm_P7.62mm_Horizontal
R14: 4.7kΩ; R_Axial_DIN0207_L6.3mm_D2.5mm_P7.62mm_Horizontal

Connections:
+5V: BZ1.1 (+), C1.1, C2.1, J1.21, J3.5, J4.3, J7.1, J8.1, J12.1, J16.6, R15.1
/3.3v: J1.1, J18.1, J_I2C1.1
/+5V_SERVO: C3.1, J6.1, J9.1, J10.2, J11.2, J13.3, J14.3, R9.1, R16.1
/+11.1V: J4.1, J13.1, J_MOTOR1.2, Q3.1 (G), R10.1, R12.2, R14.1
/+IR: J15.2, R9.2
/-IR: J15.1, Q2.1 (C)
/BATT_SENSE: C4.2, J2.4, R10.2, R11.2
/BCLK: J1.9, J16.2, J18.5
/BUZZER_CTRL: J2.11, R13.2
/DHT_DATA: J1.4, J7.2
/DIN: J1.10, J16.3
/ECHO: J1.11, J6.3, R1.1, R2.2
/I2C_SCL: J2.12, J_I2C1.4
/I2C_SDA: J2.13, J_I2C1.3
/I2S_DIN: J1.12, J18.3
/IN1: J1.18, J3.1
/IN2: J1.19, J3.2
/IN3: J1.17, J3.3
/IN4: J1.16, J3.4
/IR_TX: J2.5, R7.2
/LED_DATA: J2.7, J9.2
/LIGHT_CTRL: J2.6, R5.1, R6.2
/LRC: J1.8, J16.1, J18.4
/Led_1: J14.1, R3.1
/Led_2: J14.2, R4.1
/PIR_OUT: J1.15, J8.2
/PI_GLOBAL_EN: J_PI_RESET1.1, Q4.1 (C)
/PI_GND: J_PI_RESET1.2, Q4.3 (E)
/PI_HARD_RESET: J2.10, R17.1
/RX_PI: J2.2, J12.4
/SERVO_PAN: J2.8, J10.1
/SERVO_TILT: J2.9, J11.1
/TRIG: J1.5, J6.2
/TX_PI: J2.3, J12.3
GND: C1.2, C2.2, C3.2, C4.1, D1.1 (K), D2.1 (K), D3.1 (K), J2.1, J3.6, J4.2, J4.4, J5.1, J6.4, J7.3, J8.3, J9.3, J10.3, J11.3, J12.2, J13.2, J13.4, J16.4, J16.5, J18.2, J18.6, J_DOCK1.1, J_I2C1.2, J_MOTOR1.1, Q1.3 (E), Q2.3 (E), Q5.3 (E), R6.1, R8.2, R11.1; also elsewhere on the board
unnamed: BZ1.2 (-), Q5.1 (C)
unnamed: D1.2 (A), R14.2
unnamed: D2.2 (A), R15.2
unnamed: D3.2 (A), R16.2
unnamed: D_CHG1.2 (A), R12.1
unnamed: D_CHG1.1 (K), F1.1, J5.2
unnamed: D_DOCK1.2 (A), Q3.2 (S)
unnamed: D_DOCK1.1 (K), J_DOCK1.2
unnamed: Q1.2 (B), R5.2
unnamed: Q1.1 (C), R3.2, R4.2
unnamed: Q2.2 (B), R7.1, R8.1
unnamed: F1.2, Q3.3 (D)
unnamed: Q4.2 (B), R17.2
unnamed: Q5.2 (B), R13.1
unnamed: R1.2, R2.1

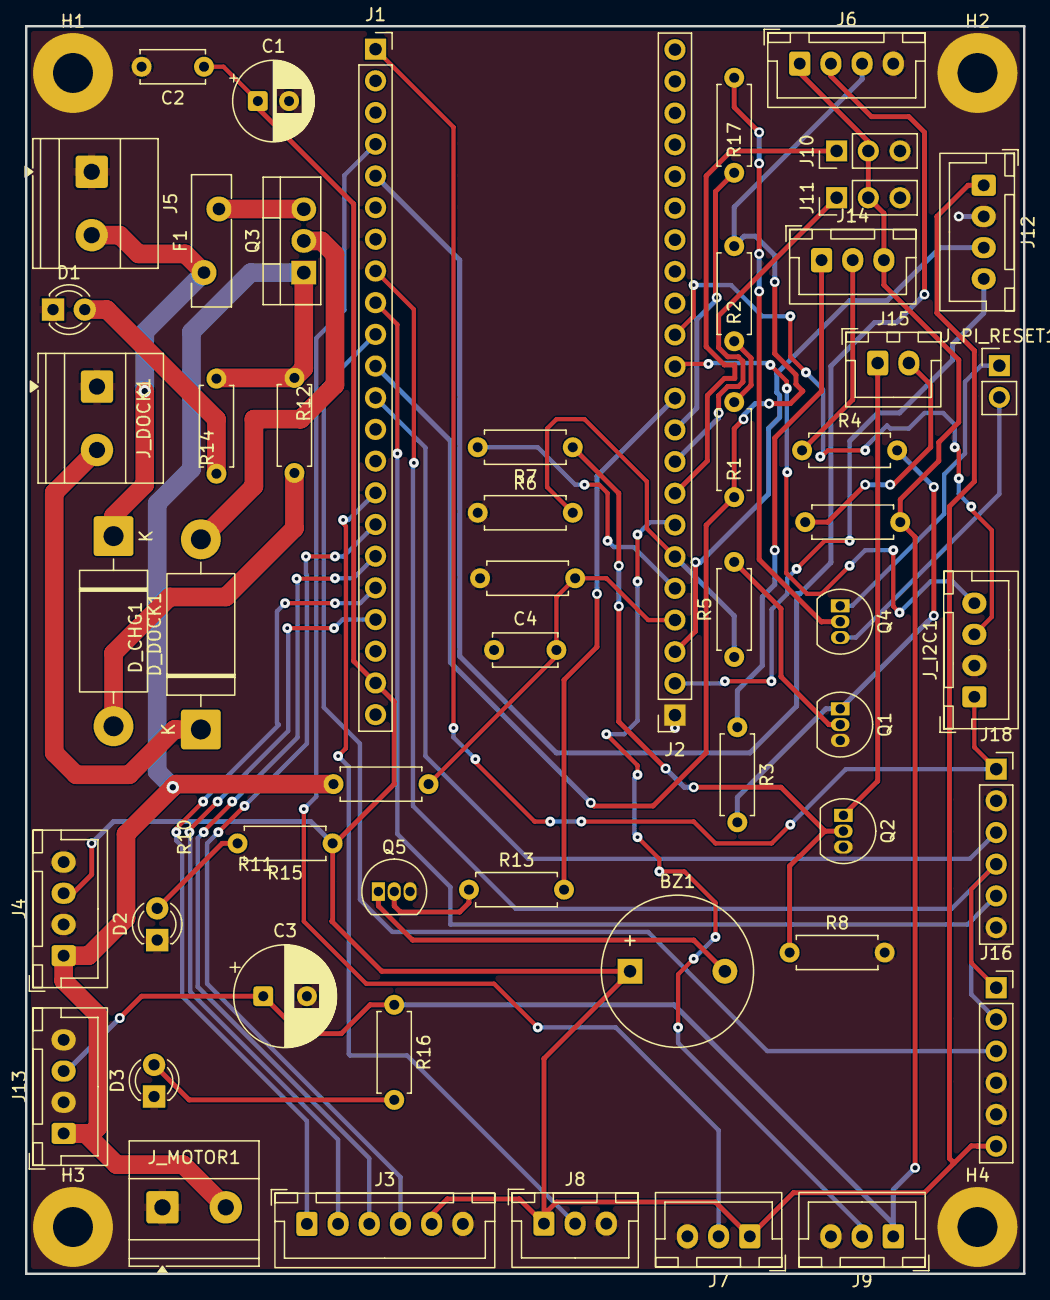
[picture p18: board Aura_Rover_Carrier_Final.kicad_pcb from above]

Board: 2 copper layers, 80.0 x 100.0 mm, 58 parts (0 on the bottom side), 50 nets.

Other parts of the board:
H1, H2, H3, H4: M3_Mounting_Hole; MountingHole_3.2mm_M3_Pad

Their connections:
GND: H1.1, H2.1, H3.1, H4.1; also elsewhere on the board
