shravanmali/Aura-v1/hardware/Aura_Satellite_Pod/Aura_Satellite_Pod.kicad_pcb

## KiCad design hardware/Aura_Satellite_Pod/Aura_Satellite_Pod.kicad_pcb (2026-11-08)

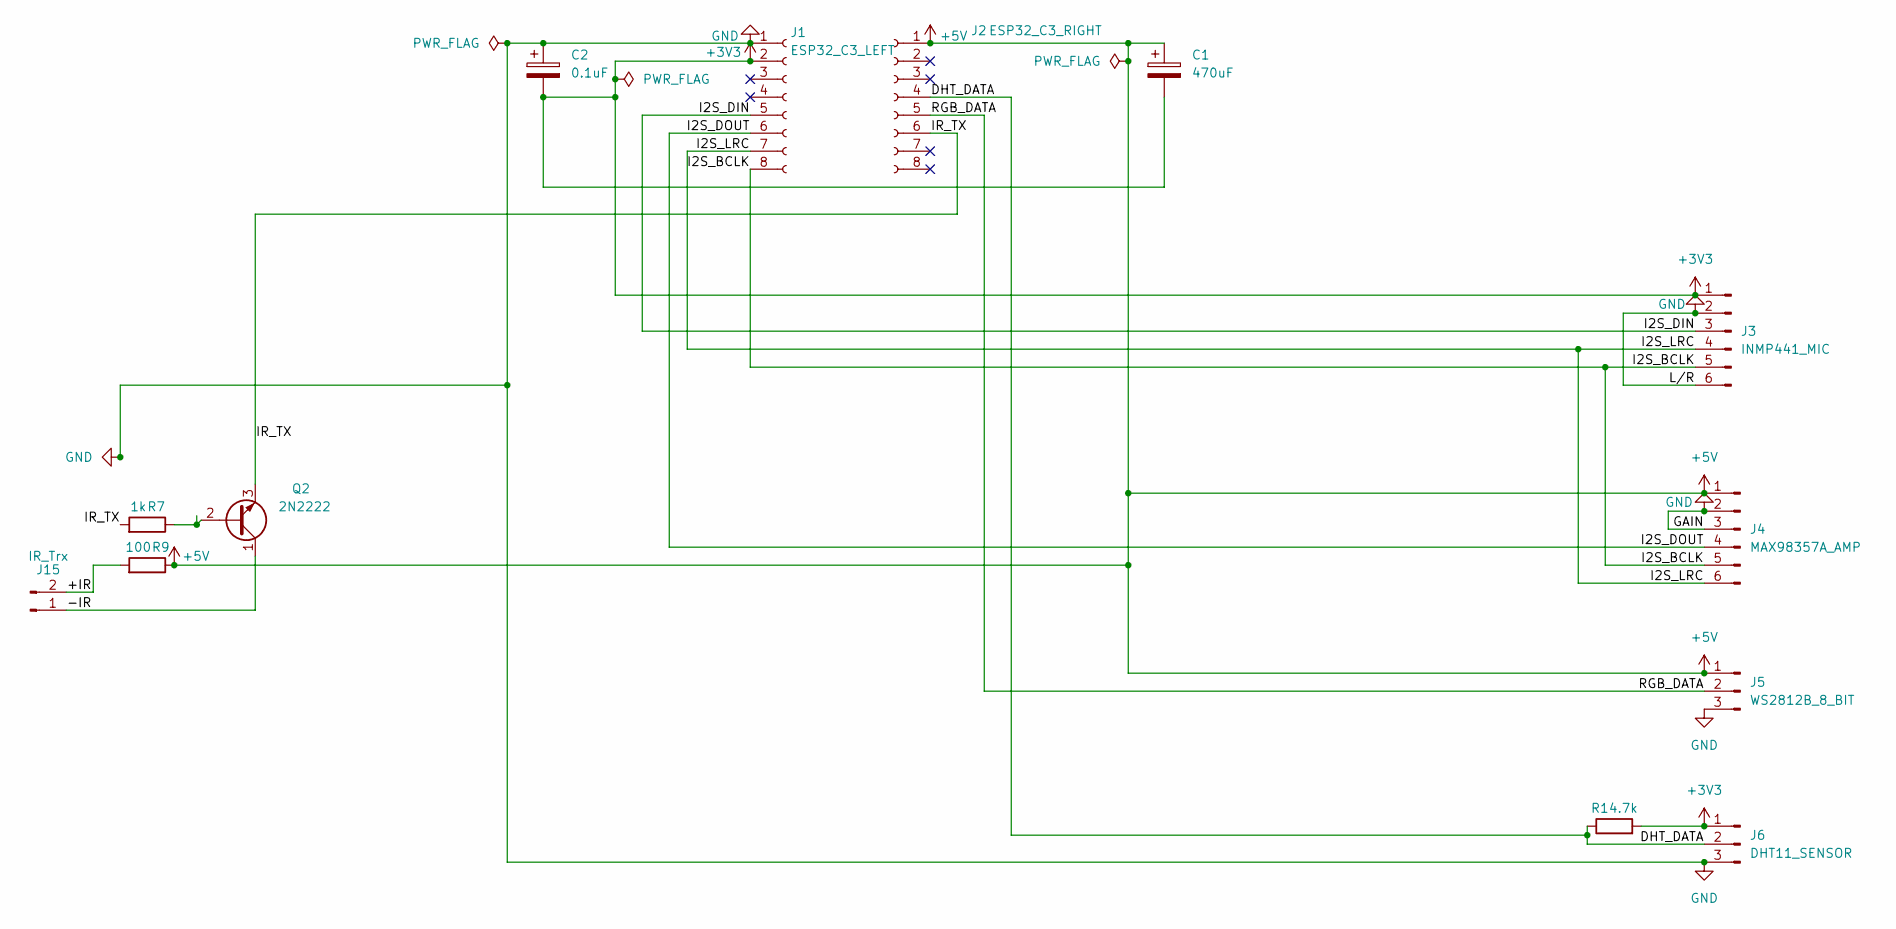
[picture p19: schematic Aura_Satellite_Pod.kicad_sch]

Parts:
C1: 470uF; CP_Radial_D8.0mm_P3.50mm
C2: 0.1uF; C_Disc_D4.3mm_W1.9mm_P5.00mm
J1: ESP32_C3_LEFT; PinSocket_1x08_P2.54mm_Vertical
J2: ESP32_C3_RIGHT; PinSocket_1x08_P2.54mm_Vertical
J3: INMP441_MIC; PinHeader_1x06_P2.54mm_Vertical
J4: MAX98357A_AMP; PinHeader_1x06_P2.54mm_Vertical
J5: WS2812B_8_BIT; PinHeader_1x03_P2.54mm_Vertical
J6: DHT11_SENSOR; PinHeader_1x03_P2.54mm_Vertical
J15: IR_Trx; PinHeader_1x02_P2.54mm_Vertical
Q2: 2N2222; TO-92_Inline
R1: 4.7k; R_Axial_DIN0207_L6.3mm_D2.5mm_P7.62mm_Horizontal
R7: 1k; R_Axial_DIN0207_L6.3mm_D2.5mm_P7.62mm_Horizontal
R9: 100; R_Axial_DIN0207_L6.3mm_D2.5mm_P7.62mm_Horizontal

Connections:
+3V3: C1.2, C2.2, J1.2, J3.1, J6.1, R1.2
+5V: C1.1, J2.1, J4.1, J5.1, R9.1
/+IR: J15.2, R9.2
/-IR: J15.1, Q2.1 (C)
/DHT_DATA: J2.4, J6.2, R1.1
/I2S_BCLK: J1.8, J3.5, J4.5
/I2S_DIN: J1.5, J3.3
/I2S_DOUT: J1.6, J4.4
/I2S_LRC: J1.7, J3.4, J4.6
/IR_TX: J2.6, Q2.3 (E), R7.2
/RGB_DATA: J2.5, J5.2
GND: C2.1, J1.1, J3.2, J3.6, J4.2, J4.3, J5.3, J6.3
unnamed: Q2.2 (B), R7.1

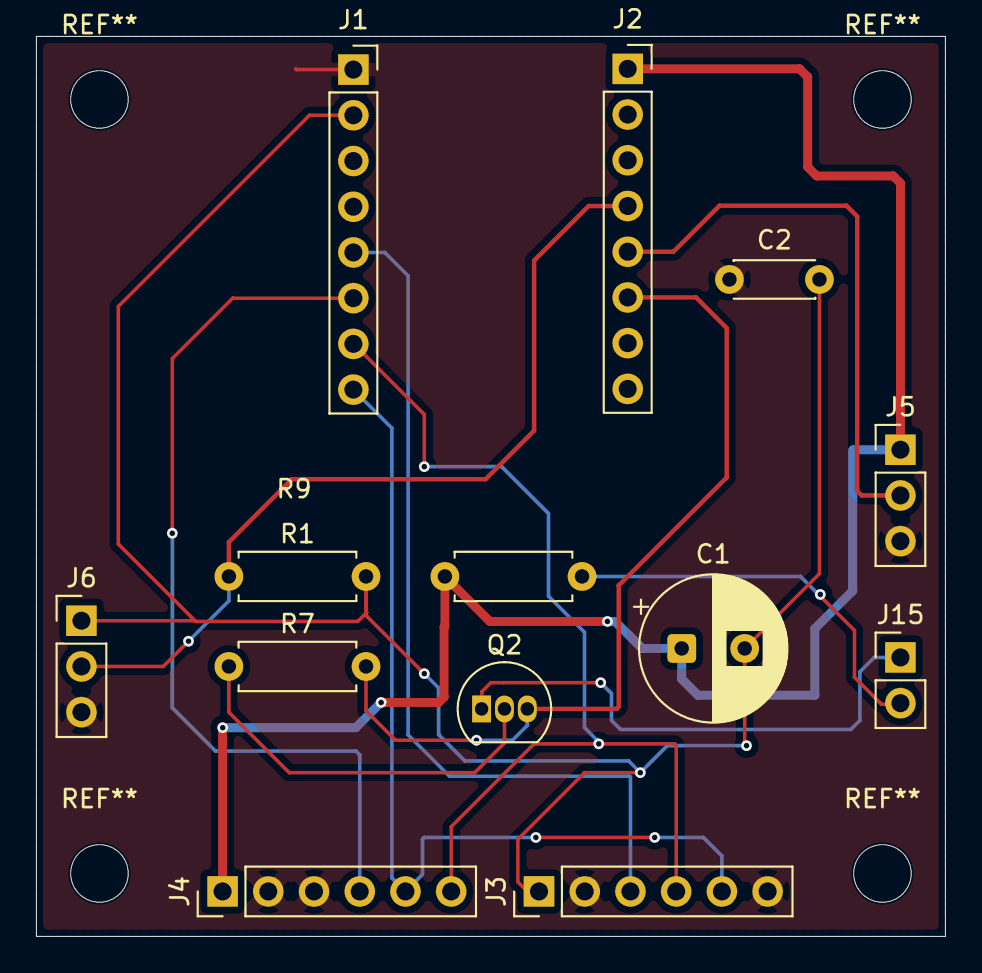
[picture p20: board Aura_Satellite_Pod.kicad_pcb from above]

Board: 2 copper layers, 50.5 x 50.0 mm, 13 parts (0 on the bottom side), 13 nets.
