shravanmali/Aura-v1/(commit log)

2026-11-02 initial commit: aura v1 rover firmware, vision tracking and 3d model
    [BOM.csv, aura_v1_chassis.scad]
2026-11-03 feat: add hc-sr04 auto-brake logic and update readme with guard mode
2026-11-03 hardware: initial kicad carrier board schematic v1 with 0 errors
    [Aura_v1_Carrier.kicad_sch]
2026-11-04 feat: add dht11 and pir sensor telemetry to esp32 and vision hud
2026-11-04 hardware: upgrade carrier board to v1.1 with dht11 and pir headers
    [Aura_v1.1_Carrier.kicad_sch]
2026-11-04 bom: update bom.csv with raspberry pi 4 and indian vendor links
    [BOM.csv]
2026-11-05 hardware: add secondary buck converter for servos and pi 4 port
    [Aura_v1.3_Carrier.kicad_sch]
2026-11-05 hardware: add gimbal servos, floodlights, ir transmitter and export v1.3 pdf
    [Aura_v1.3_Carrier.kicad_sch]
2026-11-07 hardware: update carrier v1.4 schematic pins for firmware gpios and isolate servo buck rail
    - Realigned motor driver and sensor pins on J1 to match src/main.cpp firmware
    - Separated secondary LM2596 buck converter to dedicated +5V_SERVO rail
    - Exported updated printable schematic PDF (Aura_v1.4_Carrier_Schematic.pdf)
    [Aura_v1.4_Carrier.kicad_sch]
2026-11-08 hardware: add carrier v1.5 schematic with i2s audio mic, amplifier, speaker header, and battery fuel gauge
    [Aura_v1.5_Carrier.kicad_sch]
2026-11-08 Satellite Pod KiCad Schematic
    - ESP32-C3 SuperMini bedside companion hub schematic passing ERC with 0 errors
    - INMP441 I2S MEMS microphone and MAX98357A I2S 3W audio amplifier
    - WS2812B RGB halo ring, DHT11 room climate sensor, and 2N2222 high-power IR blaster
    - 470uF bulk decoupling capacitor to eliminate speaker inrush brownouts
    - Plotted high-resolution schematic PDF
    [Aura_Satellite_Pod.kicad_sch]
2026-11-08 hardware: assign standard footprints to satellite pod schematic symbols
    [Aura_Satellite_Pod.kicad_sch]
2026-11-08 Satellite Pod PCB Files with 3D screenshots
    - Complete 2-layer PCB layout verified with 0 DRC violations and 0 unconnected items
    - Dual-row female headers (J1 & J2) spaced at exactly 15.24mm for ESP32-C3 SuperMini
    - Subsystems: INMP441 I2S microphone, MAX98357A I2S amplifier, 470uF anti-brownout capacitor, WS2812B RGB ring header, DHT11 room sensor, and 2N2222-driven IR blaster
    - Dual ground copper pour (F.Cu and B.Cu) with thermal relief connections
    - Included front, back, and side 3D PCB renders and JLCPCB/PCBWay fabrication gerbers zip archive
    [Aura_Satellite_Pod.kicad_pcb]
2026-11-09 Organize project structure into cad, hardware archive, and docs folders
    - Move OpenSCAD 3D chassis models and renders to cad/
    - Move whiteboard architecture photograph to docs/
    - Move previous carrier revisions (v1.0 to v1.4) into hardware/archive/
    - Keep hardware/ focused on active Aura_v1.5_Carrier and Aura_Satellite_Pod
    [Aura_v1.1_Carrier.kicad_sch, Aura_v1.3_Carrier.kicad_sch, Aura_v1.4_Carrier.kicad_sch, Aura_v1_Carrier.kicad_sch, aura_v1_chassis.scad]
2026-11-09 Modify BOM.csv with updated links and notes
    Updated purchase link format for Raspberry Pi 4 Model B and added a note about the BOM submission.
    [BOM.csv]
2026-11-09 Revise BOM for Aura v1 Hardware Grant Submission
    Updated the Bill of Materials (BOM) for Aura v1 to include detailed component information and links for grant submission.
    [BOM.csv]
2026-11-09 Add master hardware inventory and grant request BOM files
    - Add Aura_Master_BOM.md and Aura_Master_BOM.csv covering all 32 hardware subsystems
    - Clearly separate hardware owned on desk (₹2,320) from grant request (₹9,528)
    - Add BOM.md with clickable vendor purchase links for Hack Club Fallen reviewers
    [Aura_Master_BOM.csv]
2026-11-10 Add Aura v1.6 Carrier schematic, documentation, and BOM
    - Complete KiCad schematic (Aura_v1.6_Carrier.kicad_sch) for Aura v1.6 Carrier board
    - Integrated automatic power switching and dock battery charging (P-MOSFET Q3 + Schottky D_DOCK / D_CHG)
    - Exported vector schematic PDF (Aura_v1.6_Carrier_Schematic.pdf)
    - Added carrier Bill of Materials (Aura_v1.6_Carrier_BOM.csv) and KiCad project file
    [Aura_v1.6_Carrier.kicad_sch, Aura_v1.6_Carrier_BOM.csv]
2026-11-11 final Aura Rover Carrier PCB, schematics, and JLCPCB Gerbers
    - Finalized Aura Rover Carrier Motherboard (0 DRC errors, 0 unconnected items)
    - Exported production JLCPCB Gerbers and drill zip archive
    - Exported production schematic PDF and comprehensive BOM
    - Archived historical v1.5 carrier revision into hardware/archive/
    - Updated README documentation and firmware pin mappings
    [Aura_Rover_Carrier_Final.kicad_pcb, Aura_Rover_Carrier_Final.kicad_sch, Aura_Rover_Carrier_Final_BOM.csv, Aura_v1.5_Carrier.kicad_sch]
